SOMOS-HARDWARE-DESIGN/PRJ_CABINET_IOT/Manufacturing files/V1R1/PBM/PBM_CABINET-IOT_1.1.20261112.xlsx

Project: | CABINET IOT |  |  | Company: | Somos Internet
Revision: | V1R1 |  |  | Date: | 12/11/2026
Assembly Variant: | EVT-1 |  |  | Total Quantity: | 336
Description | Designator | Comment | Manufacturer | Manufacturer Part Number | Supplier | Supplier Part Number | Quantity
CAP CER 10uF 25V X5R 0603 | C1, C2, C105, C111, C116, C402, C403, C410, C413 | 10uF | Samsung Electro-Mechanics | CL10A106MA8NRNC | LCSC | C96446 | 9
CAP CER 100nF 50V X7R 0402 | C3, C4, C5, C6, C7, C8, C101, C103, C106, C109, C112, C115, C200, C203, C204, C206, C210, C211, C212, C213, C214, C215, C216, C217, C225, C226, C227, C229, C231, C233, C234, C235, C236, C237, C238, C239, C240, C243, C244, C301, C400, C401, C416, C417, C418, C419, C500, C501, C502, C503, C504, C506 | 0.1uF | YAGEO | AC0402KRX7R9BB104 | LCSC | C2888326 | 52
CAP SAFETY 220nF ±10% 275V 310V TH | C100, C119 | 220nF | WALSON | C42Q322448P40001 | LCSC | C46638866 | 2
CAP ALUM 100uF ±20% 50V SMD | C102 | 100uF | JIERR | RV50V100M8X10 | LCSC | C48935390 | 1
CAP CER 47uF 6.3V X5R 0805 | C107, C108 | 47uF | Samsung Electro-Mechanics | CL21A476MQYNNNE | LCSC | C16780 | 2
CAP CER 1uF 16V X5R 0402 | C110, C209, C218, C220, C221, C222, C228, C230, C232, C505 | 1uF | Samsung Electro-Mechanics | CL05A105KO5NNNC | LCSC | C29266 | 10
CAP CER 22uF 6.3V X5R 0603 | C113, C241, C242 | 22uF | Samsung Electro-Mechanics | CL10A226MQ8NRNC | LCSC | C59461 | 3
CAP SAFETY 2.2nF ±20% 250V TH | C117, C118 | 2.2nF | Dersonic | CY2222MD1IEF46J2A8 | LCSC | C2761720 | 2
CAP CER 10uF 10V X5R 0402 | C201, C202, C207, C219, C223, C224, C414, C415 | 10uF | Chinocera | HGC0402R5106M100NTEJ | LCSC | C7472949 | 8
CAP CER 470pF 25V NP0 0402 | C208 | 470pF | YAGEO | CC0402JRNPO8BN471 | LCSC | C541369 | 1
CAP CER 18pF 50V NP0 0402 | C245, C246 | 18pF | YAGEO | CC0402JRNPO9BN180 | LCSC | C106202 | 2
CAP CER 1nF 2kV X7R 1206 | C247, C507 | 1000pF | YAGEO | CC1206KKX7RDBB102 | LCSC | C23631 | 2
CAP CER 1nF 630V X7R 0603 | C248 | 1000pF | KEMET | C0603W102KBRAC7867 | LCSC | C3839369 | 1
CAP FILM 100nF ±5% 630V TH | C300 | 100nF | KYET | KP104J2J0702 | LCSC | C19273038 | 1
CAP SAFETY 470nF ±10% 275V TH | C404 | 470nF | WALSON | C42P247438P40001 | LCSC | C46638871 | 1
CAP ALUM 470uF ±20% 35V SMD | C405, C406 | 470uF | KNSCHA | RVT470UF35V67RV0056 | LCSC | C2836436 | 2
CAP CER 33nF 1kV X7R 1210 | C407, C408, C411 | 33nF | HUI JU | NV1210B333K102CEGN | LCSC | C720962 | 3
TVS Diode | D3, D4, D500, D501 | ESD | Slkor | SLESD0402-V05 | LCSC | C7496586 | 4
Default Diode | D100, D101 | 20V 1A | onsemi | MBR120VLSFT1G | LCSC | C48677824 | 2
LED EMERALD GREEN WATER CLEAR 0402 SMD | D200, D201 | GRN | EVERLIGHT | 16-213/GHC-YR1S1/3T | LCSC | C74338 | 2
DIODES S1M-13-F | D300, D301, D302 | S1M-13-F | DIODES | S1M-13-F | LCSC | C155378 | 3
Default Diode | D400, D402 | 1N4007FL | SMC | 1N4007FL | LCSC | C493190 | 2
Zener Diode | D401 | 1SMA4744A | MDD(Microdiode Semiconductor) | 1SMA4744A | LCSC | C173484 | 1
FERRITE BEAD 600Ω 0603 1LN | FB200, FB201 | 600OHM | TAI-TECH | HCB1608KF-601T20 | LCSC | C304319 | 2
CONN RCPT Type-C 16POS SMD | J1 | USB C | Korean Hroparts Elec | TYPE-C-31-M-12 | LCSC | C165948 | 1
Connector Accessories SFP Cage Right Angle Copper Alloy Nickel Tray | J200 | SFP 2227023 1X1Y | CND-tek | SFP 2227023 1X1Y | LCSC | C42931382 | 1
CONN SFP RCPT 20POS SLD R/A SMD | J201 | SFP20 47030-00J191 | CND-Tek | SFP20 47030-00J191 | LCSC | C50159076 | 1
CONN HEADER TH 3POS 2mm | J300, J301 | LS | JST | B3B-PH-K-S(LF)(SN) | LCSC | C131339 | 2
CONN MOD JACK RJ45 TH R/A SHIELDED | J500 | KH-RJ45-58-8P8C | kinghelm | KH-RJ45-58-8P8C | LCSC | C2683360 | 1
CONN HEADER TH 4POS 2mm | J501 | STH1 | JST | B4B-PH-K-S(LF)(SN) | LCSC | C131334 | 1
CONN HEADER TH 3POS 2mm | J503 | WS | JST | B3B-PH-K-S(LF)(SN) | LCSC | C131339 | 1
CONN HEADER TH 3POS 2mm | J504 | MQ-7 | JST | B3B-PH-K-S(LF)(SN) | LCSC | C131339 | 1
CONN HEADER TH 4POS 2mm | J505 | STH2 | JST | B4B-PH-K-S(LF)(SN) | LCSC | C131334 | 1
CONN HEADER TH 4POS 2mm | J507 | STH3 | JST | B4B-PH-K-S(LF)(SN) | LCSC | C131334 | 1
CONN HEADER TH 4POS 2mm | J508 | STH4 | JST | B4B-PH-K-S(LF)(SN) | LCSC | C131334 | 1
Songle Relay SRD-05VDC-SL-C | K300 | SRD-05VDC-SL-C | Songle Relay | SRD-05VDC-SL-C | LCSC | C35449 | 1
FIXED IND 12UH 1.4A 135 MOHM SMD | L100 | 15uH | cjiang | FNR5020S150MT | LCSC | C167939 | 1
Chip Inductor SMD | L201 | 2.2uH | TDK | VLS252010CX-2R2M-1 | LCSC | C2896594 | 1
CMC 1.5A 2LN 1.4KOHM SMD | LC100 | PDUUAT98-103MLN | PROD Tech | PDUUAT98-103MLN | LCSC | C2909797 | 1
RF TXRX MOD BT WIFI TH SMD | MOD1 | ESP32-WROOM-32E-N8 | Espressif Systems | ESP32-WROOM-32E-N8 | LCSC | C701342 | 1
Optocoupler DC-IN 1-CH Transistor DC-OUT 4-Pin PDIP SMD | OK400 | PC817CS | AOTE | PC817CS | LCSC | C20612591 | 1
TRANS NPN 40V 200mA SOT-23 | Q1, Q2 | NPN | onsemi | MMBT3904 | LCSC | C242260 | 2
MOSFET N-CH 60V 5.6A SOT-223 | Q300, Q301, Q302 | DMN6068SE-13 | DIODES | DMN6068SE-13 | LCSC | C209902 | 3
P-Channel Power MOSFET | Q500 | AO3401 | UMW | AO3401 | LCSC | C347476 | 1
N-Channel Power MOSFET | Q501 | AO3400 | UMW | AO3400 | LCSC | C347475 | 1
RES 5.1kΩ ±1% 62.5mW 0402 | R1, R2, R6, R7, R26, R27, R200, R201, R202, R203, R204, R235, R236, R240, R241, R242, R248, R421, R424, R425, R426 | 5.1K | YAGEO | RC0402FR-075K1L | LCSC | C105872 | 21
RES 1kΩ ±1% 62.5mW 0402 | R3, R5, R12, R13, R14, R30, R31, R32, R40, R41, R42, R43, R44, R45, R46, R47, R205, R400, R406, R407, R408, R409 | 1K | YAGEO | RC0402FR-071KL | LCSC | C106235 | 22
RES 0Ω ±5% 100mW 0603 | R4, R232, R239, R404, R504, R505, R508 | 0R | YAGEO | RC0603JR-070RL | LCSC | C95177 | 7
Chip Resistor SMD | R10, R11 | 470R | YAGEO | RC0402FR-07470RL | LCSC | C114877 | 2
RES 100Ω ±1% 62.5mW 0402 | R15, R16, R17, R18, R19, R245, R301, R303, R306 | 100R | YAGEO | RC0402FR-07100RL | LCSC | C106232 | 9
RES 22Ω ±1% 62.5mW 0402 | R20, R21, R500, R501 | 22R | YAGEO | RC0402FR-0722RL | LCSC | C114765 | 4
RES 0Ω ±1% 62.5mW 0402 | R22, R29, R48, R49, R50, R51, R52, R53, R54, R55, R56, R57, R58, R59, R60, R61, R62, R63, R206, R208, R237, R238, R502 | 0R | YAGEO | RC0402FR-070RL | LCSC | C106231 | 23
RES 10kΩ ±1% 62.5mW 0402 | R23, R24, R25, R28, R33, R35, R37, R39, R100, R215, R225, R226, R227, R231, R251, R302, R304, R305, R307, R308, R423, R427, R428, R431, R432, R503, R507, R509 | 10K | YAGEO | RC0402FR-0710KL | LCSC | C60490 | 28
RES 100kΩ ±1% 100mW 0603 | R101 | 100k | FOJAN | FRC0603F1003TS | LCSC | C2906980 | 1
RES 13.3kΩ ±1% 100mW 0603 | R102 | 13.3k | FOJAN | FRC0603F1332TS | LCSC | C2933140 | 1
RES 1.5kΩ ±1% 62.5mW 0402 | R207 | 1.5k | YAGEO | RC0402FR-071K5L | LCSC | C114759 | 1
RES 10Ω ±1% 62.5mW 0402 | R209, R210, R216, R252 | 10R | UNI-ROYAL | 0402WGF100JTCE | LCSC | C25077 | 4
RES 49.9Ω ±1% 62.5mW 0402 | R211, R212, R213, R214 | 49.9R | FOJAN | FRC0402F49R9TS | LCSC | C2933103 | 4
RES 27Ω ±1% 62.5mW 0402 | R217, R218 | 27R | FOJAN | FRC0402F27R0TS | LCSC | C2909343 | 2
RES 33Ω ±1% 62.5mW 0402 | R219, R223 | 33R | YAGEO | RC0402FR-0733RL | LCSC | C138002 | 2
RES 12.1kΩ ±1% 62.5mW 0402 | R222 | 12.1k | UNI-ROYAL | 0402WGF1212TCE | LCSC | C25852 | 1
RES 75Ω ±1% 100mW 0603 | R243, R244 | 75R | HWA CHN | HRC0603F75R0ENTN | LCSC | C54920947 | 2
RES 2.49kΩ ±1% 62.5mW 0402 | R249 | 2.49K | FOJAN | FRC0402F2491TS | LCSC | C2933083 | 1
RES 100Ω ±5% 1W 2512 | R300, R402, R403 | 100R | FOJAN | FRC2512J101 TS | LCSC | C2907569 | 3
RES 470kΩ ±1% 500mW 1210 | R401 | 470k | FOJAN | FRC1210F4703TS | LCSC | C3000657 | 1
RES 10kΩ ±1% 500mW 1210 | R405, R414 | 10k | FOJAN | FRC1210F1002TS | LCSC | C2974059 | 2
RES 1kΩ ±1% 500mW 1210 | R410, R415, R420 | 1k | FOJAN | FRC1210F1001TS | LCSC | C2960861 | 3
RES 249Ω ±1% 500mW 1210 | R412, R413 | 249R | FOJAN | FRC1210F2490TS | LCSC | C3000542 | 2
RES 330kΩ ±1% 500mW 1210 | R417, R418, R419 | 330k | FOJAN | FRC1210F3303TS | LCSC | C51048344 | 3
PTC RESET FUSE 250V 600mA TH | RT100 | BK250-600-SZ | Brightking | BK250-600-SZ | LCSC | C94464 | 1
SPST- NO Momentary Button, 160g Force | S1, S2 | EVQ-P2202M | Panasonic | EVQ-P2202M | LCSC | C528967 | 2
CHIP LAN FILTER, Meets IEEE 802.3 & ANSI X3.263 Standards, Designed For 2.5G BASE - T Applications, Surface Mount Type | T200, T201 | CM3216D25-501 | CND-tek | CM3216D25-501 | LCSC | C41425874 | 2
Ultra Low ON-Resistance, Low Voltage, Dual, SPDT Analog Switch | U1 | SGM3005XMS/TR | SGMICRO | SGM3005XMS/TR | LCSC | C19618 | 1
Transceiver USB 2.0 2Mbps SOP-16_150mil USB ICs RoHS | U2 | CH340C | WCH | CH340C | LCSC | C84681 | 1
Multiplexer Switch ICs 8-CH I2C SWITCH W/RESET | U3 | PCA9548APW,118 | NXP | PCA9548APW,118 | LCSC | C21198 | 1
20W Series of Ultra-compact Power Module | U100 | HLK-20M12 | HI-LINK | HLK-20M12 | LCSC | C465408 | 1
High Efficiency Fast Response, 5A, 30V Input Synchronous Step Down Regulator | U101 | SY8205FCC | Silergy | SY8205FCC | LCSC | C111875 | 1
3.3V Positive Fixed SOT-223 Voltage Regulators - Linear, Low Drop Out (LDO) Regulators | U102 | BL8071GCLBTR33 | BL | BL8071GCLBTR33 | LCSC | C49256292 | 1
Small Footprint RMII 10/100 Ethernet Transceiver with HP Auto-MDiX Support | U200 | LAN8720A-CP-TR | Microchip | LAN8720A-CP-TR | LCSC | C45223 | 1
10/100/1000M Copper to 100Base-FX/1000Base-X Fiber Media Converter | U201 | RTL8213B-CG | Realtek | RTL8213B-CG | LCSC | C2766076 | 1
SINGLE 2-INPUT POSITIVE OR GATE | U300 | 74LVC1G32SE-7 | DIODES | 74LVC1G32SE-7 | LCSC | C460530 | 1
16-Bit ADC with Integrated Multiplexer, PGA, Comparator, Oscillator, and Reference, -40 to 125 degC, 10-pin SOP (DGS10), Green (RoHS & no Sb/Br) | U400 | ADS1115IDGSR | Texas Instruments | ADS1115IDGSR | LCSC | C37593 | 1
Low-dropout linear regulator with 250 mA output current, 55 V voltage withstand, and low quiescent current | U401 | HT7550H-TD(55V) | TDSEMIC | HT7550H-TD(55V) | LCSC | C49023494 | 1
Low-Power, RRIO, 1-MHz Operational Amplifier for Cost-Sensitive Systems | U402, U404 | TLV9002IDR | TI | TLV9002IDR | LCSC | C398360 | 2
Single-phase metering IC | U403 | HLW8032 | Hiliwei Tech | HLW8032 | LCSC | C128023 | 1
3V to 5.5V multi-channel RS-232 line drivers and receivers with +15kV IEC ESD protection | U500 | MAX3232EIPWR | TI | MAX3232EIPWR | LCSC | C406863 | 1
Three-axis micromachined digital accelerometer | U501 | SC7A20HTR | Hangzhou Silan Microelectronics | SC7A20HTR | LCSC | C19274408 | 1
810V 385V 300V 470V Through Hole,P=5mm Varistors, MOVs | VR100, VR400 | FTR05D471K-C3Z3 | SURGING | FTR05D471K-C3Z3 | LCSC | C55233803 | 2
TERM BLOCK HDR 2POS 7.5MM | X100 | AC INPUT | Cixi Kefa Elec | KF2EDGRC-7.5-2P | LCSC | C976440 | 1
CRYSTAL 25MHz 16pF SMD | X200 | 25Mhz | YXC Crystal Oscillators | X322525MQB4SI | LCSC | C70585 | 1
TERM BLOCK HDR 2POS 7.5MM | X300 | FAN 1/2 | Cixi Kefa Elec | KF2EDGRC-7.5-2P | LCSC | C976440 | 1
TERM BLOCK HDR 2POS 7.5MM | X301 | FAN 3/4 | Cixi Kefa Elec | KF2EDGRC-7.5-2P | LCSC | C976440 | 1
TERM BLOCK HDR 2POS 5MM | X302, X303 | ElectroMagnet | Cixi Kefa Elec | KF2EDGRC-5.0-2P | LCSC | C441225 | 2
TERM BLOCK HDR 2POS 5MM | X401, X402, X403 | CT CLAMP DC | Cixi Kefa Elec | KF2EDGRC-5.0-2P | LCSC | C441225 | 3
XTAL OSC 50MHz CMOS SMD | Y200 | 50MHz | SCTF | SX2M50.000M20F30TNN | LCSC | C2901606 | 1
