SOMOS-HARDWARE-DESIGN/PRJ_CABINET_IOT/Manufacturing files/V1R1/2D-3D/P3D_CABINET-IOT_1.1.20261112.step/P3D_CABINET-IOT_1.1.20261112.step

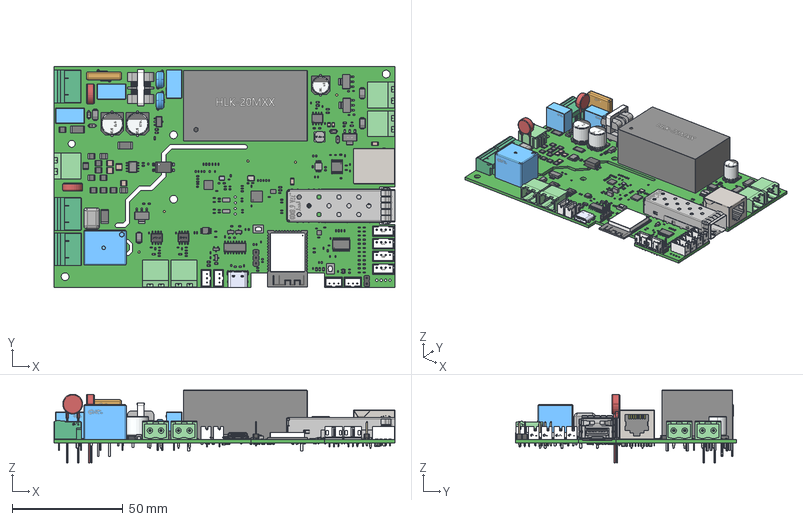
[picture p1: CAD file, 2026-11-13]
Manufacturing files/V1R1/2D-3D/P3D_CABINET-IOT_1.1.20261112.step/P3D_CABINET-IOT_1.1.20261112.step
154.0 x 100.0 x 32.8 mm
pin_header_aw140-eg-g02d
User Library-3-lead sot23-3 x 4
Mid_Body x 159
Mark x 159
Extruded x 30
CAP-TH_L13.0-W7.0-P10.00-D0.6-1 x 3
CAP-TH_L7.5-W3.7-P7.50-D0.6-S2.0 x 2
FILTER-TH_4P-L17.0-W12.0-H16.5-P7.00-D0.6-S8.00
D0402_L1.0-W0.5-H0.5 x 4
Pin1 x 13
Pin2 x 13
CeramicBody x 13
CONN-TH_P5.00_KF2EDGRC-5.0-2P x 5
Pin001 x 2
Pin002 x 2
Pin003 x 2
Pin004 x 2
Pin005 x 2
Pin006 x 2
Pin007 x 2
Pin008 x 2
74AHCT1G32SE-7
User Library-SOT-223-1 x 3
CONN-TH_B3B-PH-K-S x 4
User Library-DO-214AC SMA x 4
OSC-SMD_4P-L2.5-W2.0-H0.6
CONN-TH_KF2EDGRC-7.5-2P x 3
User Library-3225-1
mov-07d221k_RGB153 x 2
LGA-12_L2.0-W2.0-P0.50-TL_QMA6100
Leader x 74
SOP-8_L4.9-W3.9-P1.27-LS6.0-BL-1
top
bottom
Thermal Shape
SOT-223-3_L6.5-W3.4-P2.30-LS7.0-BR
PWRM-TH_HLK-20MXX
FUSE-TH_L16.0-W4.6-H18.0-P5.1-D0.8-S4.6
pin_header_aw140-eg-g03d
User Library-DIP4_opto_iso
ESP32-WROOM-32D--3DModel-STEP-56544
VLS252010CX-2R2M-1
SRN5020TA
RELAY-TH_L19.2-W15.6-H15.8
PH2.0-LI-4P x 4
RJ45-TH_KH-RJ45-58-8P8C
User Library-SOD123F x 4
User Library-led_0402LED0402 green x 2
CAP ALUM 10_3mm x 2
leads
CAP ALUM 8_3mm
