SOMOS-HARDWARE-DESIGN/PRJ_CABINET_IOT/Manufacturing files/V1R1/PCB MFG-ASY-SCH PDF/PCB_MFG_PDF_CABINET-IOT_1.1.20261112.pdf

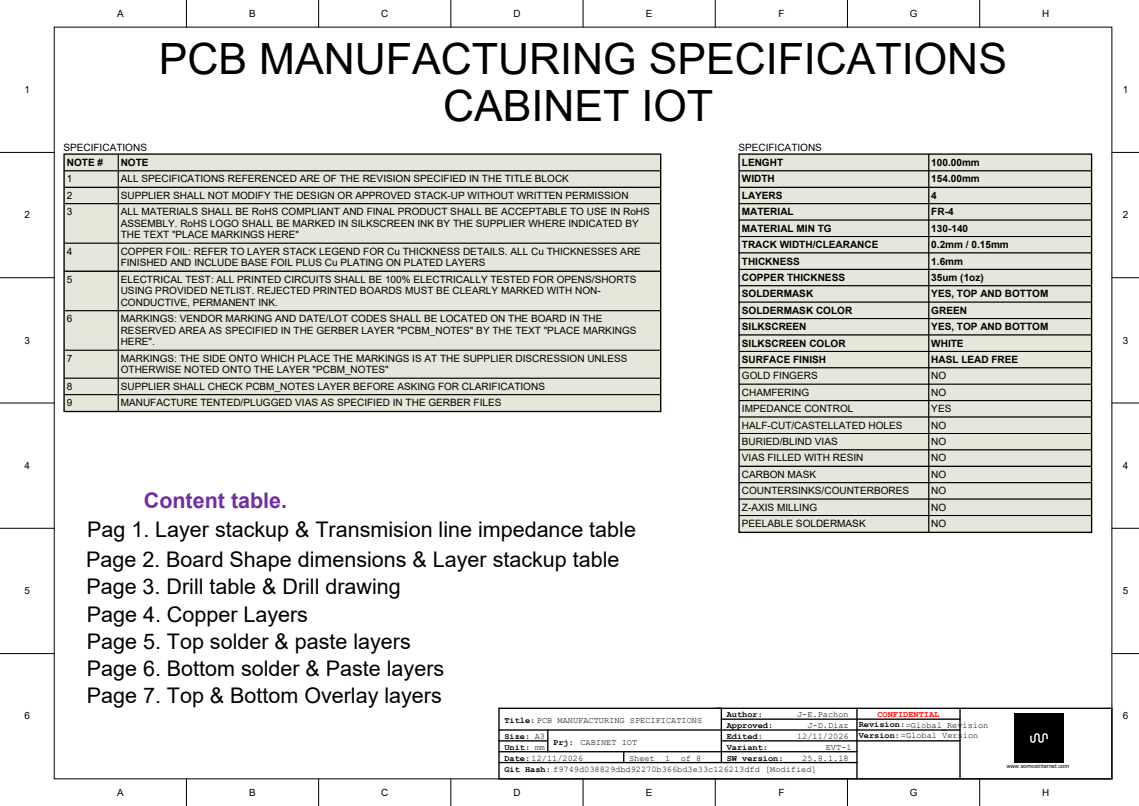
[picture p2: page 1]

NOTE
ALL SPECIFICATIONS REFERENCED ARE OF THE REVISION SPECIFIED IN THE TITLE BLOCK
SUPPLIER SHALL NOT MODIFY THE DESIGN OR APPROVED STACK-UP WITHOUT WRITTEN PERMISSION
ALL MATERIALS SHALL BE RoHS COMPLIANT AND FINAL PRODUCT SHALL BE ACCEPTABLE TO USE IN RoHS
ASSEMBLY. RoHS LOGO SHALL BE MARKED IN SILKSCREEN INK BY THE SUPPLIER WHERE INDICATED BY
THE TEXT "PLACE MARKINGS HERE"

MATERIAL MIN TG | 130-140
TRACK WIDTH/CLEARANCE | 0.2mm / 0.15mm
THICKNESS | 1.6mm

4 | COPPER FOIL: REFER TO LAYER STACK LEGEND FOR Cu THICKNESS DETAILS. ALL Cu THICKNESSES ARE FINISHED AND INCLUDE BASE FOIL PLUS Cu PLATING ON PLATED LAYERS

ELECTRICAL TEST: ALL PRINTED CIRCUITS SHALL BE 100% ELECTRICALLY TESTED FOR OPENS/SHORTS
USING PROVIDED NETLIST. REJECTED PRINTED BOARDS MUST BE CLEARLY MARKED WITH NON-
CONDUCTIVE, PERMANENT INK.

SOLDERMASK | YES, TOP AND BOTTOM
SOLDERMASK COLOR | GREEN
SILKSCREEN | YES, TOP AND BOTTOM
SILKSCREEN COLOR | WHITE

6 | MARKINGS: VENDOR MARKING AND DATE/LOT CODES SHALL BE LOCATED ON THE BOARD IN THE RESERVED AREA AS SPECIFIED IN THE GERBER LAYER "PCBM_NOTES" BY THE TEXT "PLACE MARKINGS HERE".

MARKINGS: THE SIDE ONTO WHICH PLACE THE MARKINGS IS AT THE SUPPLIER DISCRESSION UNLESS
OTHERWISE NOTED ONTO THE LAYER "PCBM_NOTES"

GOLD FINGERS | NO
CHAMFERING | NO
IMPEDANCE CONTROL | YES
HALF-CUT/CASTELLATED HOLES | NO
BURIED/BLIND VIAS | NO
VIAS FILLED WITH RESIN | NO
CARBON MASK | NO
COUNTERSINKS/COUNTERBORES | NO
Z-AXIS MILLING | NO
PEELABLE SOLDERMASK | NO

8 | SUPPLIER SHALL CHECK PCBM_NOTES LAYER BEFORE ASKING FOR CLARIFICATIONS
9 | MANUFACTURE TENTED/PLUGGED VIAS AS SPECIFIED IN THE GERBER FILES

Content table.
Pag 1. Layer stackup & Transmision line impedance table
Page 2. Board Shape dimensions & Layer stackup table
Page 3. Drill table & Drill drawing
Page 4. Copper Layers
Page 5. Top solder & paste layers
Page 6. Bottom solder & Paste layers
Page 7. Top & Bottom Overlay layers

Title: PCB MANUFACTURING SPECIFICATIONS | Author: J-E.Pachon | CONFIDENTIAL | www.somosinternet.com

Approved: J-D.Diaz | Revision: =Global_Revision

Size: A3 | Prj: CABINET IOT | Edited: 12/11/2026 | Version: =Global_Version
Unit: mm | | Variant: EVT-1
Date:12/11/2026 | Sheet 1 of 8 | SW version: 25.8.1.18

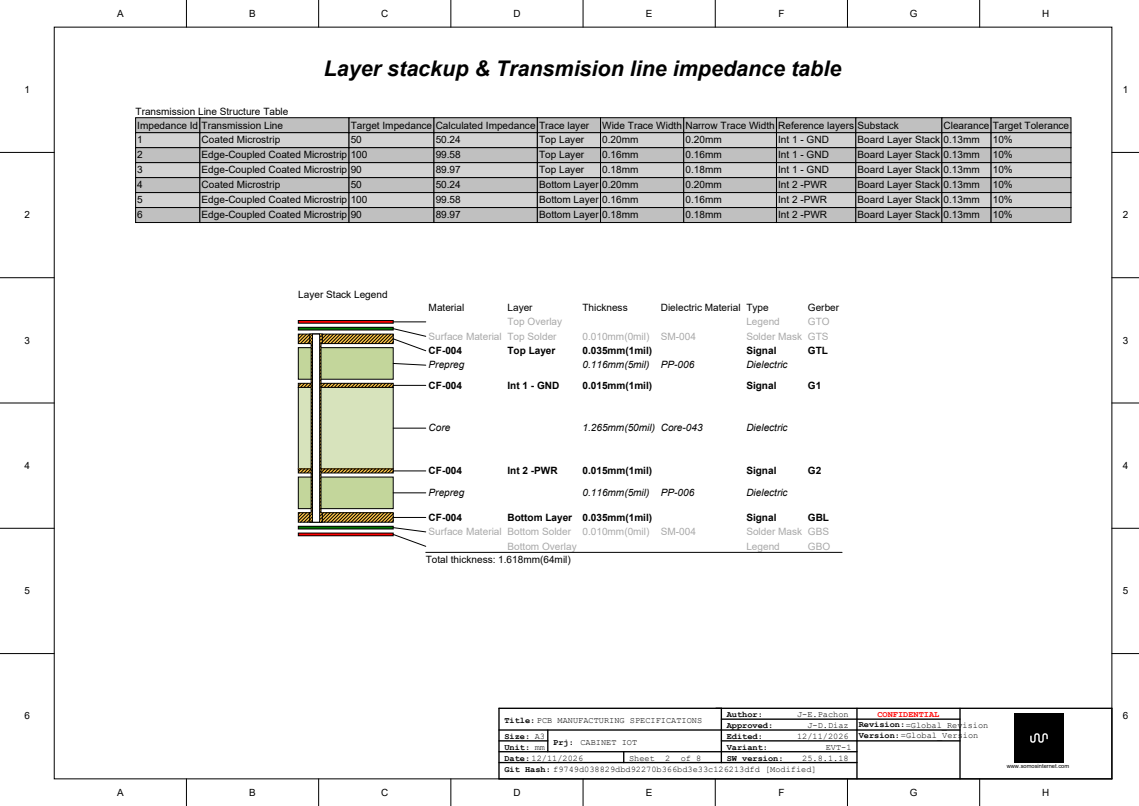
[picture p3: page 2]

Layer stackup & Transmision line impedance table

Transmission Line Structure Table

Impedance Id | Transmission Line | Target Impedance | Calculated Impedance | Trace layer | Wide Trace Width | Narrow Trace Width | Reference layers | Substack | Clearance | Target Tolerance
1 | Coated Microstrip | 50 | 50.24 | Top Layer | 0.20mm | 0.20mm | Int 1 - GND | Board Layer Stack | 0.13mm | 10%
2 | Edge-Coupled Coated Microstrip | 100 | 99.58 | Top Layer | 0.16mm | 0.16mm | Int 1 - GND | Board Layer Stack | 0.13mm | 10%
3 | Edge-Coupled Coated Microstrip | 90 | 89.97 | Top Layer | 0.18mm | 0.18mm | Int 1 - GND | Board Layer Stack | 0.13mm | 10%
4 | Coated Microstrip | 50 | 50.24 | Bottom Layer | 0.20mm | 0.20mm | Int 2 -PWR | Board Layer Stack | 0.13mm | 10%
5 | Edge-Coupled Coated Microstrip | 100 | 99.58 | Bottom Layer | 0.16mm | 0.16mm | Int 2 -PWR | Board Layer Stack | 0.13mm | 10%
6 | Edge-Coupled Coated Microstrip | 90 | 89.97 | Bottom Layer | 0.18mm | 0.18mm | Int 2 -PWR | Board Layer Stack | 0.13mm | 10%

Title: PCB MANUFACTURING SPECIFICATIONS | Author: J-E.Pachon | CONFIDENTIAL

Approved: J-D.Diaz | Revision: =Global_Revision

Size: A3 | | Edited: 12/11/2026 | Version: =Global_Version

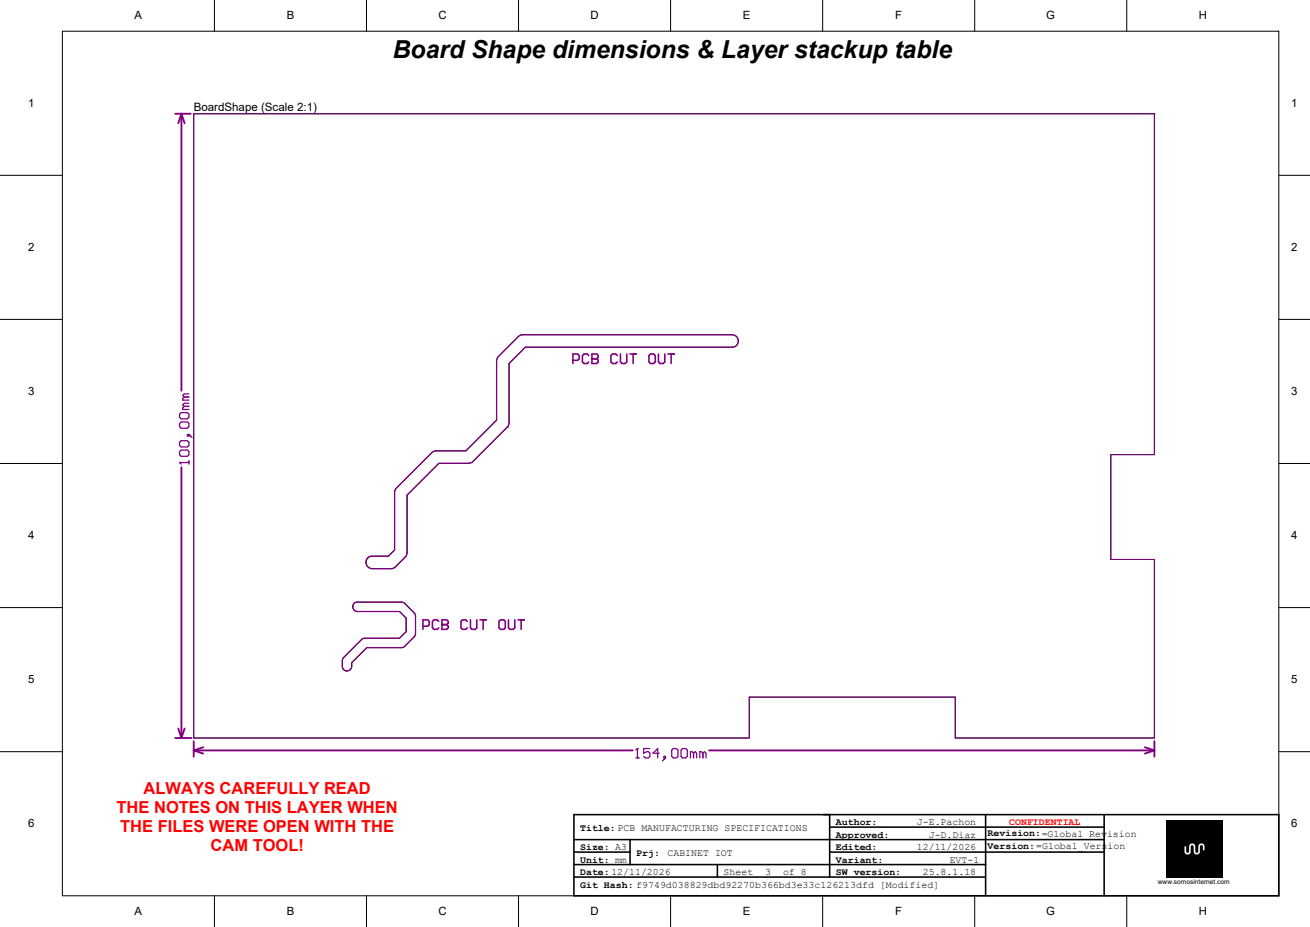
[picture p4: page 3]

Board Shape dimensions & Layer stackup table

ALWAYS CAREFULLY READ
THE NOTES ON THIS LAYER WHEN
THE FILES WERE OPEN WITH THE

Title: PCB MANUFACTURING SPECIFICATIONS | Author: J-E.Pachon | CONFIDENTIAL

Approved: J-D.Diaz | Revision: =Global_Revision

Size: A3 | | Edited: 12/11/2026 | Version: =Global_Version

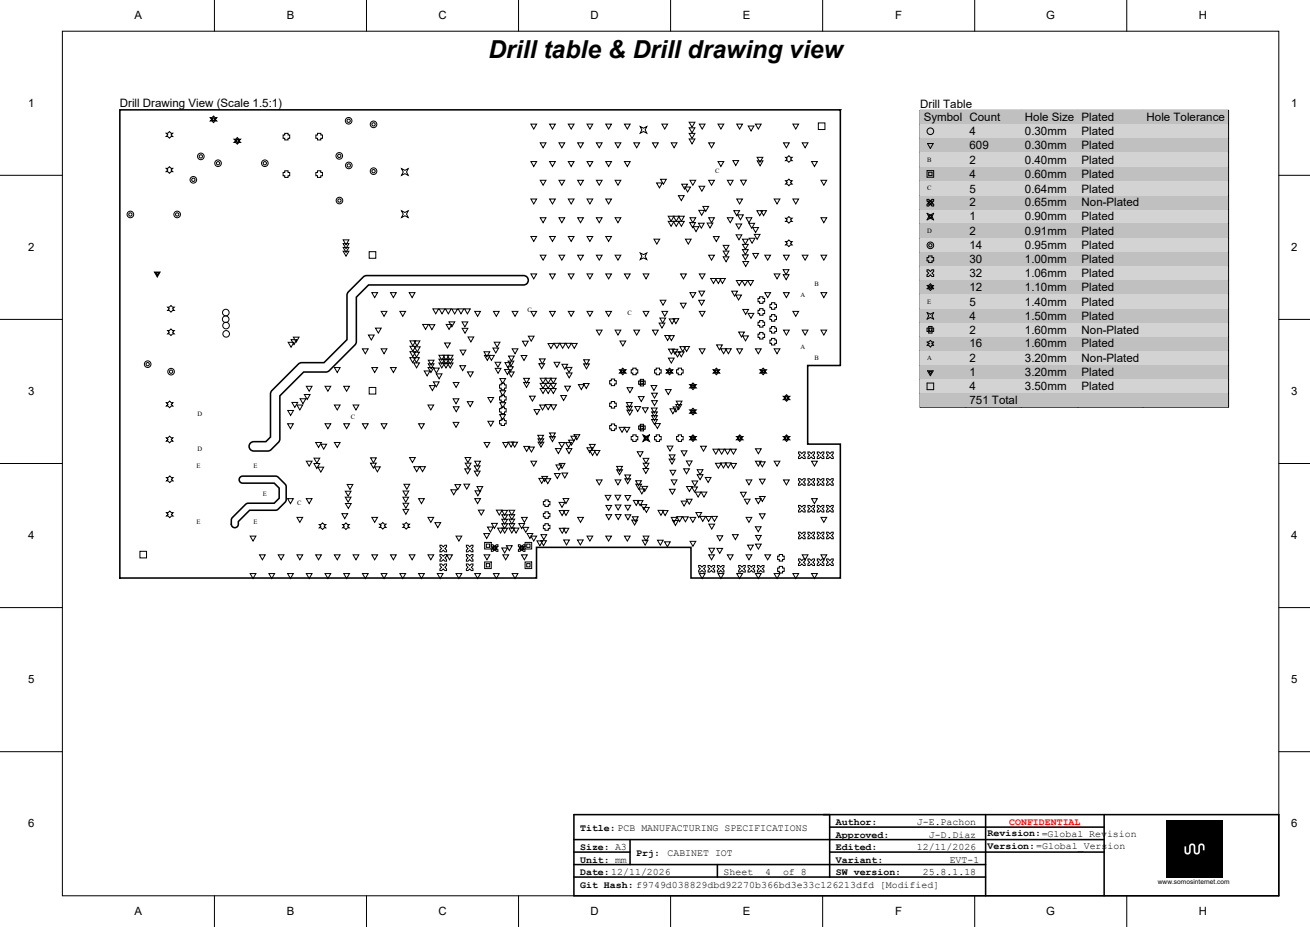
[picture p5: page 4]

Drill table & Drill drawing view

Drill Drawing View (Scale 1.5:1)

Symbol | Count | Hole Size | Plated | Hole Tolerance

4 | 0.30mm | Plated
609 | 0.30mm | Plated

B | 2 | 0.40mm | Plated

4 | 0.60mm | Plated

C | | | 5 | 0.64mm | Plated

2 | 0.65mm | Non-Plated
1 | 0.90mm | Plated

D | | | 2 | 0.91mm | Plated

14 | 0.95mm | Plated
30 | 1.00mm | Plated
32 | 1.06mm | Plated
12 | 1.10mm | Plated

E | | | 5 | 1.40mm | Plated

4 | 1.50mm | Plated
2 | 1.60mm | Non-Plated
16 | 1.60mm | Plated

A | | | 2 | 3.20mm | Non-Plated

1 | 3.20mm | Plated
4 | 3.50mm | Plated
751 Total

Title: PCB MANUFACTURING SPECIFICATIONS | Author: J-E.Pachon | CONFIDENTIAL

Approved: J-D.Diaz | Revision: =Global_Revision

Size: A3 | | Edited: 12/11/2026 | Version: =Global_Version

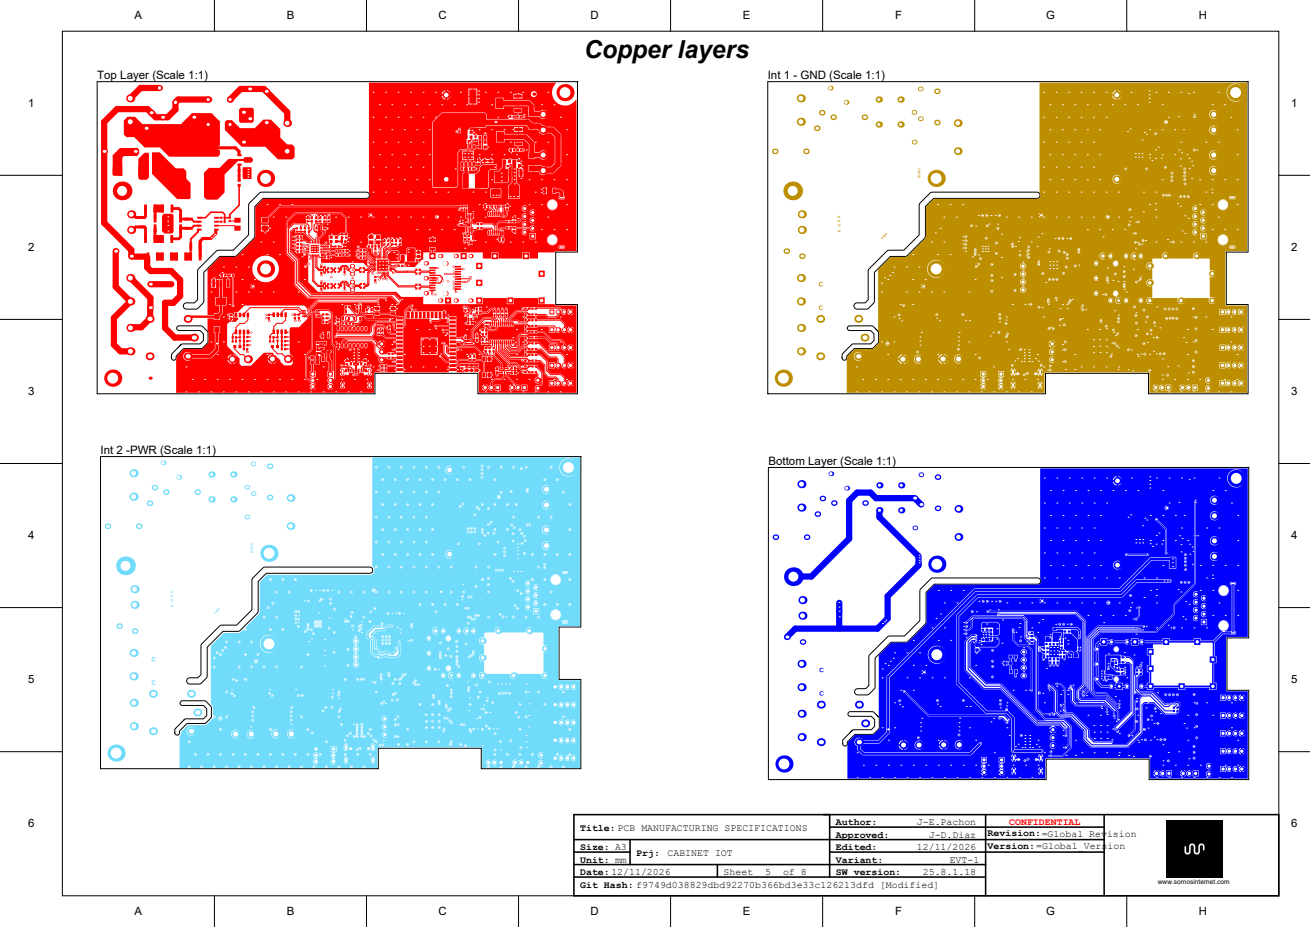
[picture p6: page 5]

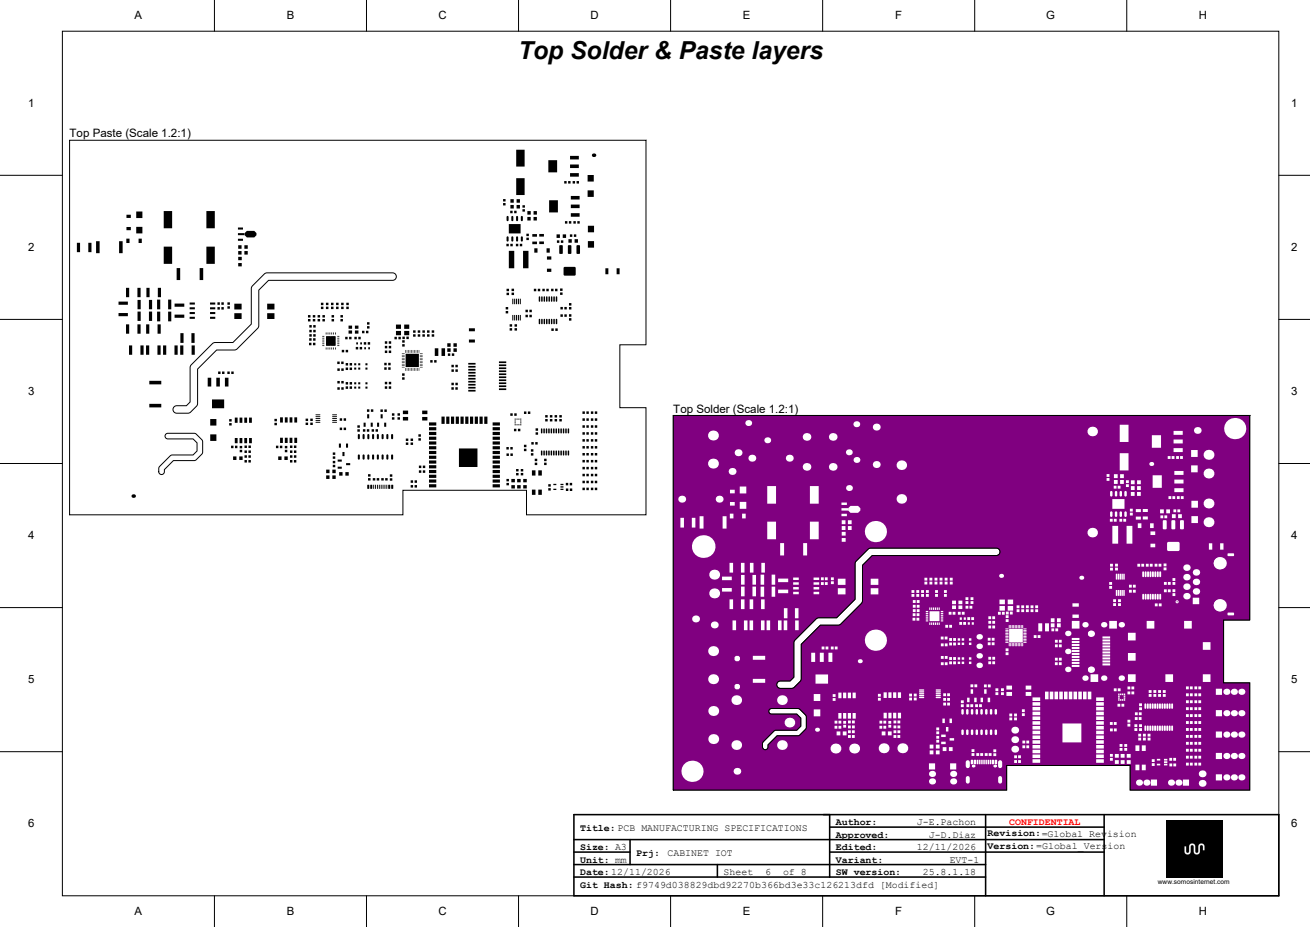
[picture p7: page 6]

Top Solder & Paste layers

Title: PCB MANUFACTURING SPECIFICATIONS | Author: J-E.Pachon | CONFIDENTIAL

Approved: J-D.Diaz | Revision: =Global_Revision

Size: A3 | | Edited: 12/11/2026 | Version: =Global_Version

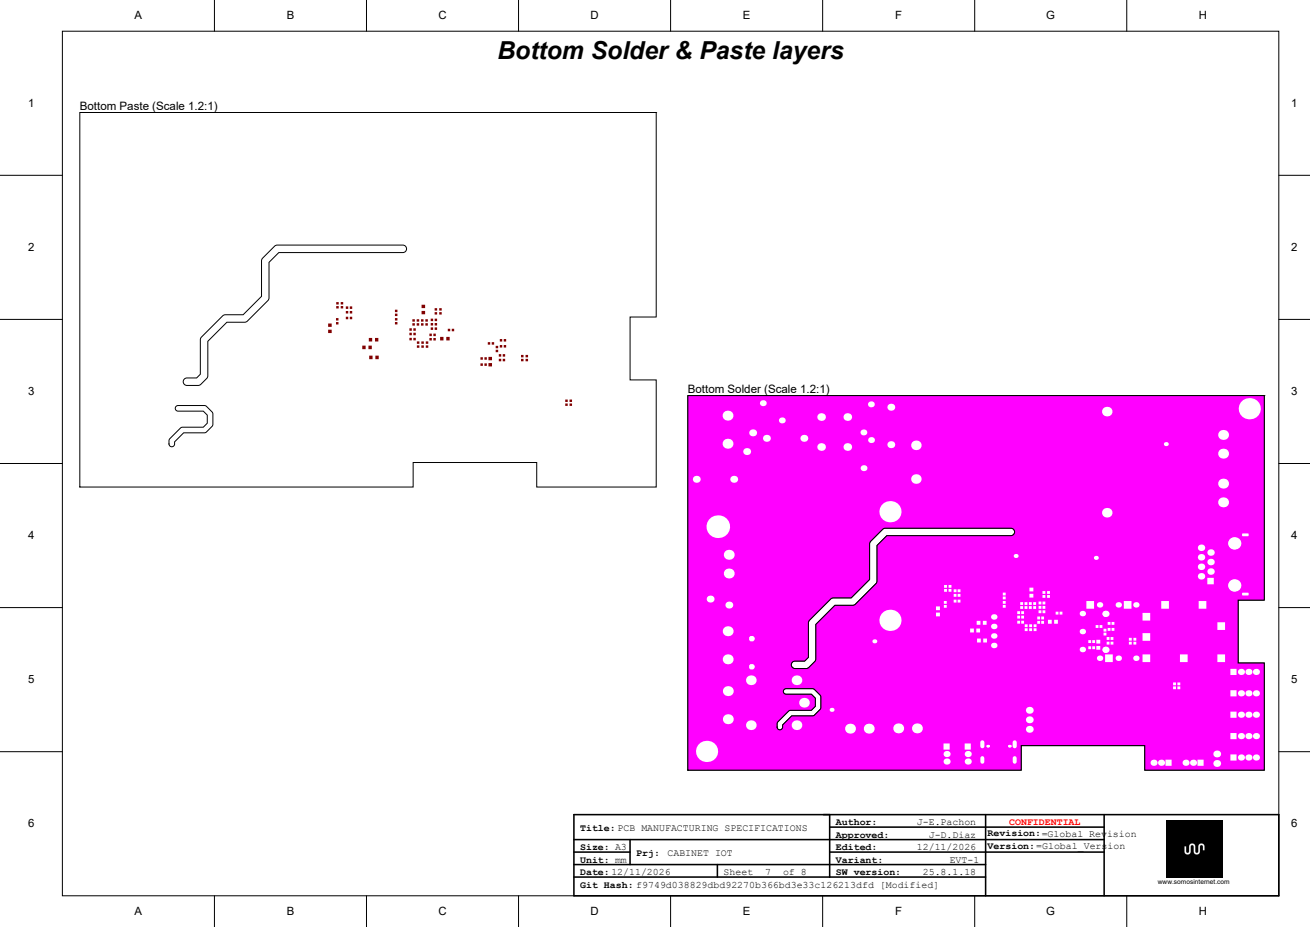
[picture p8: page 7]

Bottom Solder & Paste layers

Title: PCB MANUFACTURING SPECIFICATIONS | Author: J-E.Pachon | CONFIDENTIAL

Approved: J-D.Diaz | Revision: =Global_Revision

Size: A3 | | Edited: 12/11/2026 | Version: =Global_Version

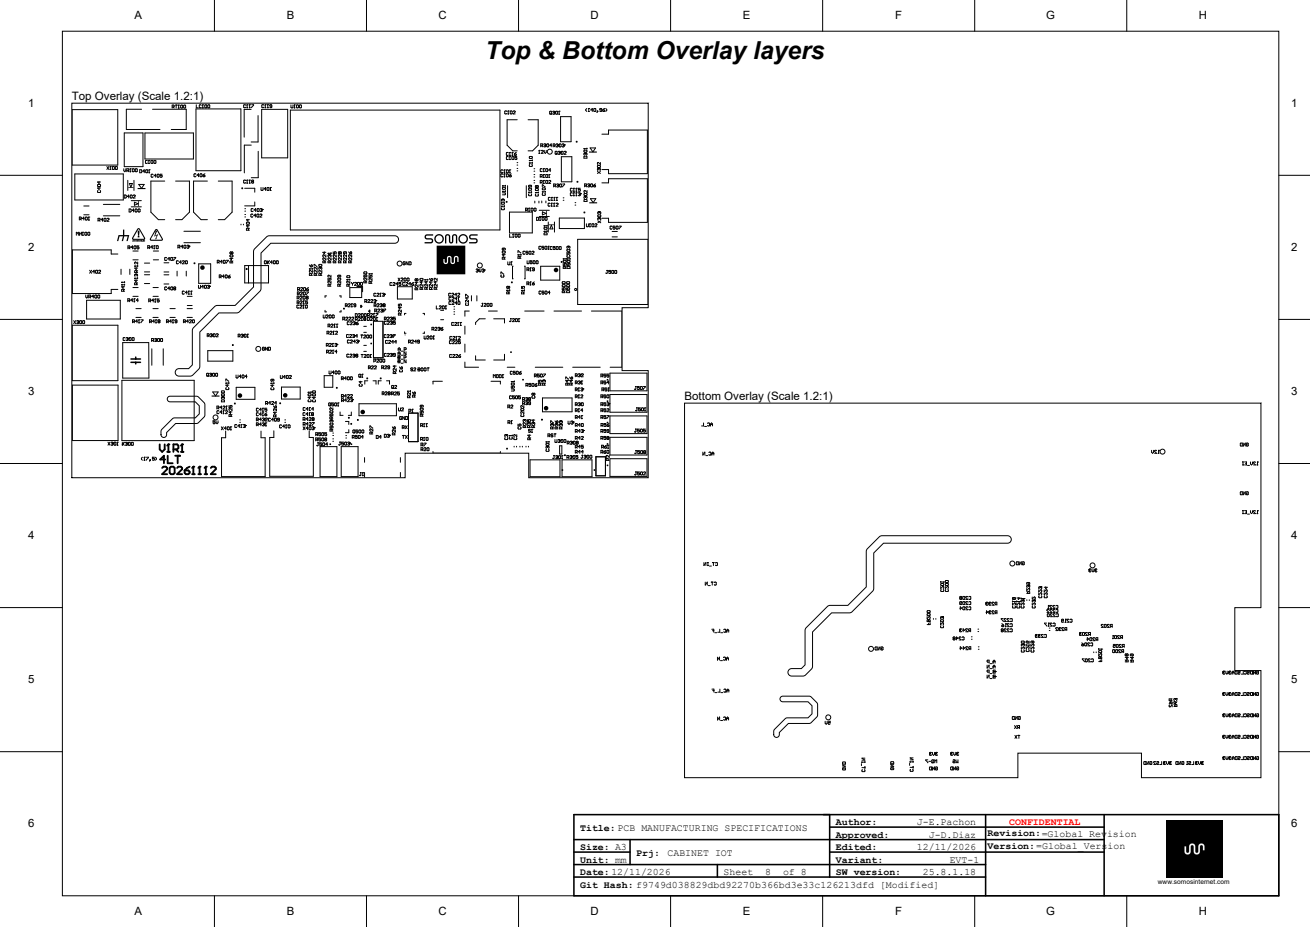
[picture p9: page 8]

Top & Bottom Overlay layers
