SOMOS-HARDWARE-DESIGN/PRJ_CABINET_IOT/Manufacturing files/V1R1/PCB MFG-ASY-SCH PDF/SCH_PDF_CABINET-IOT_1.1.20261112.pdf

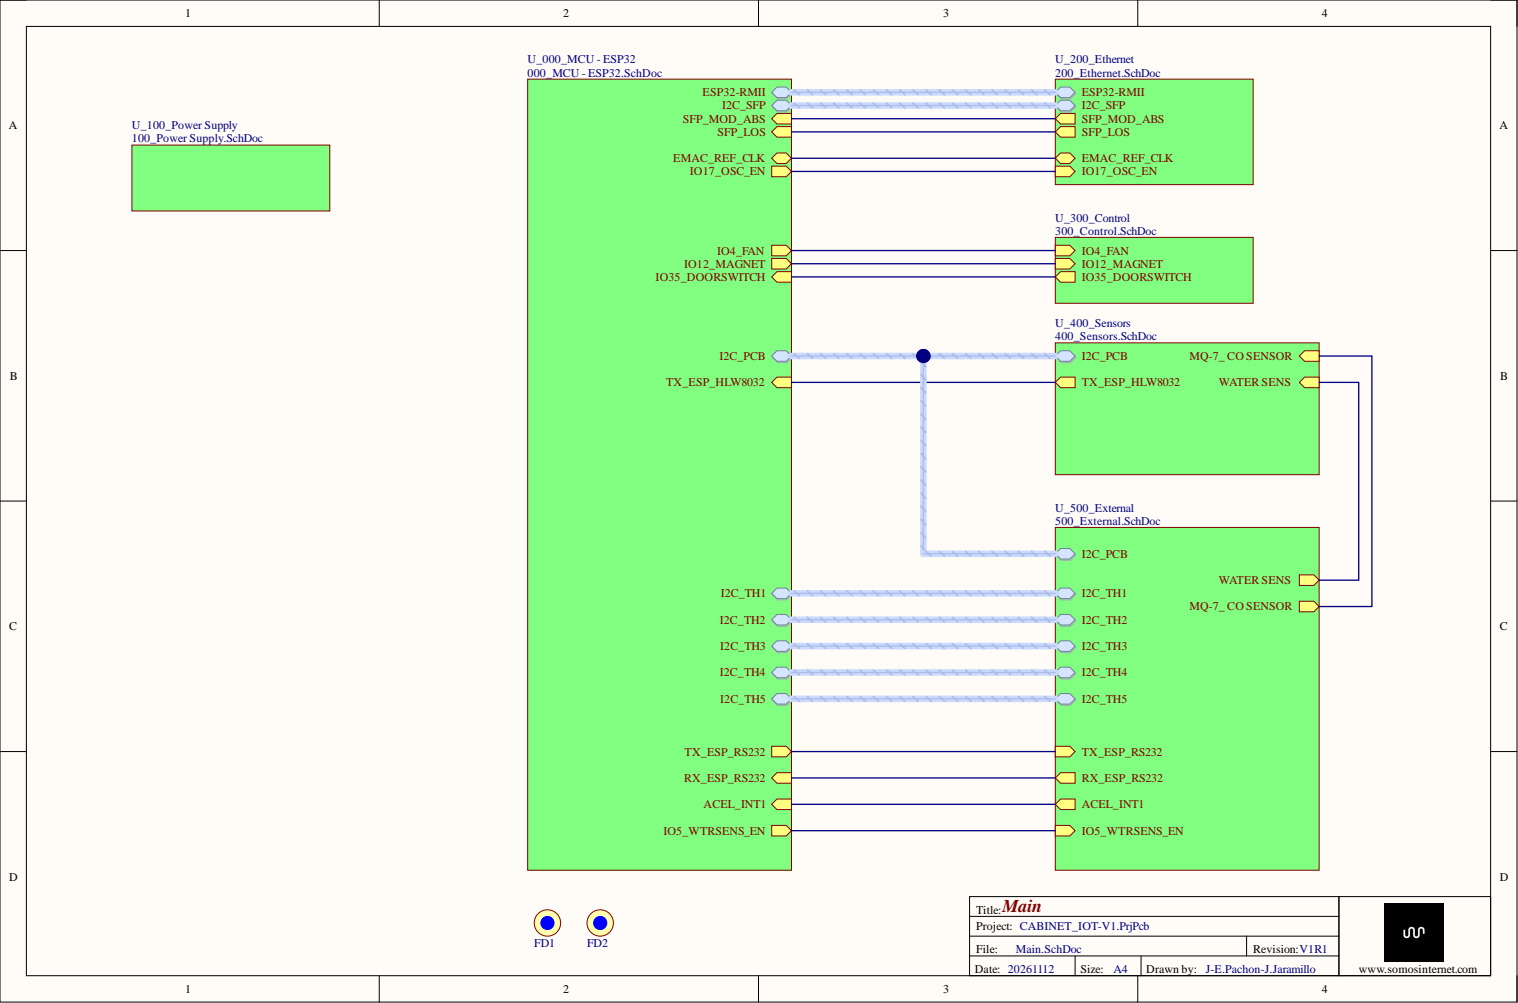
[picture p10: page 1]

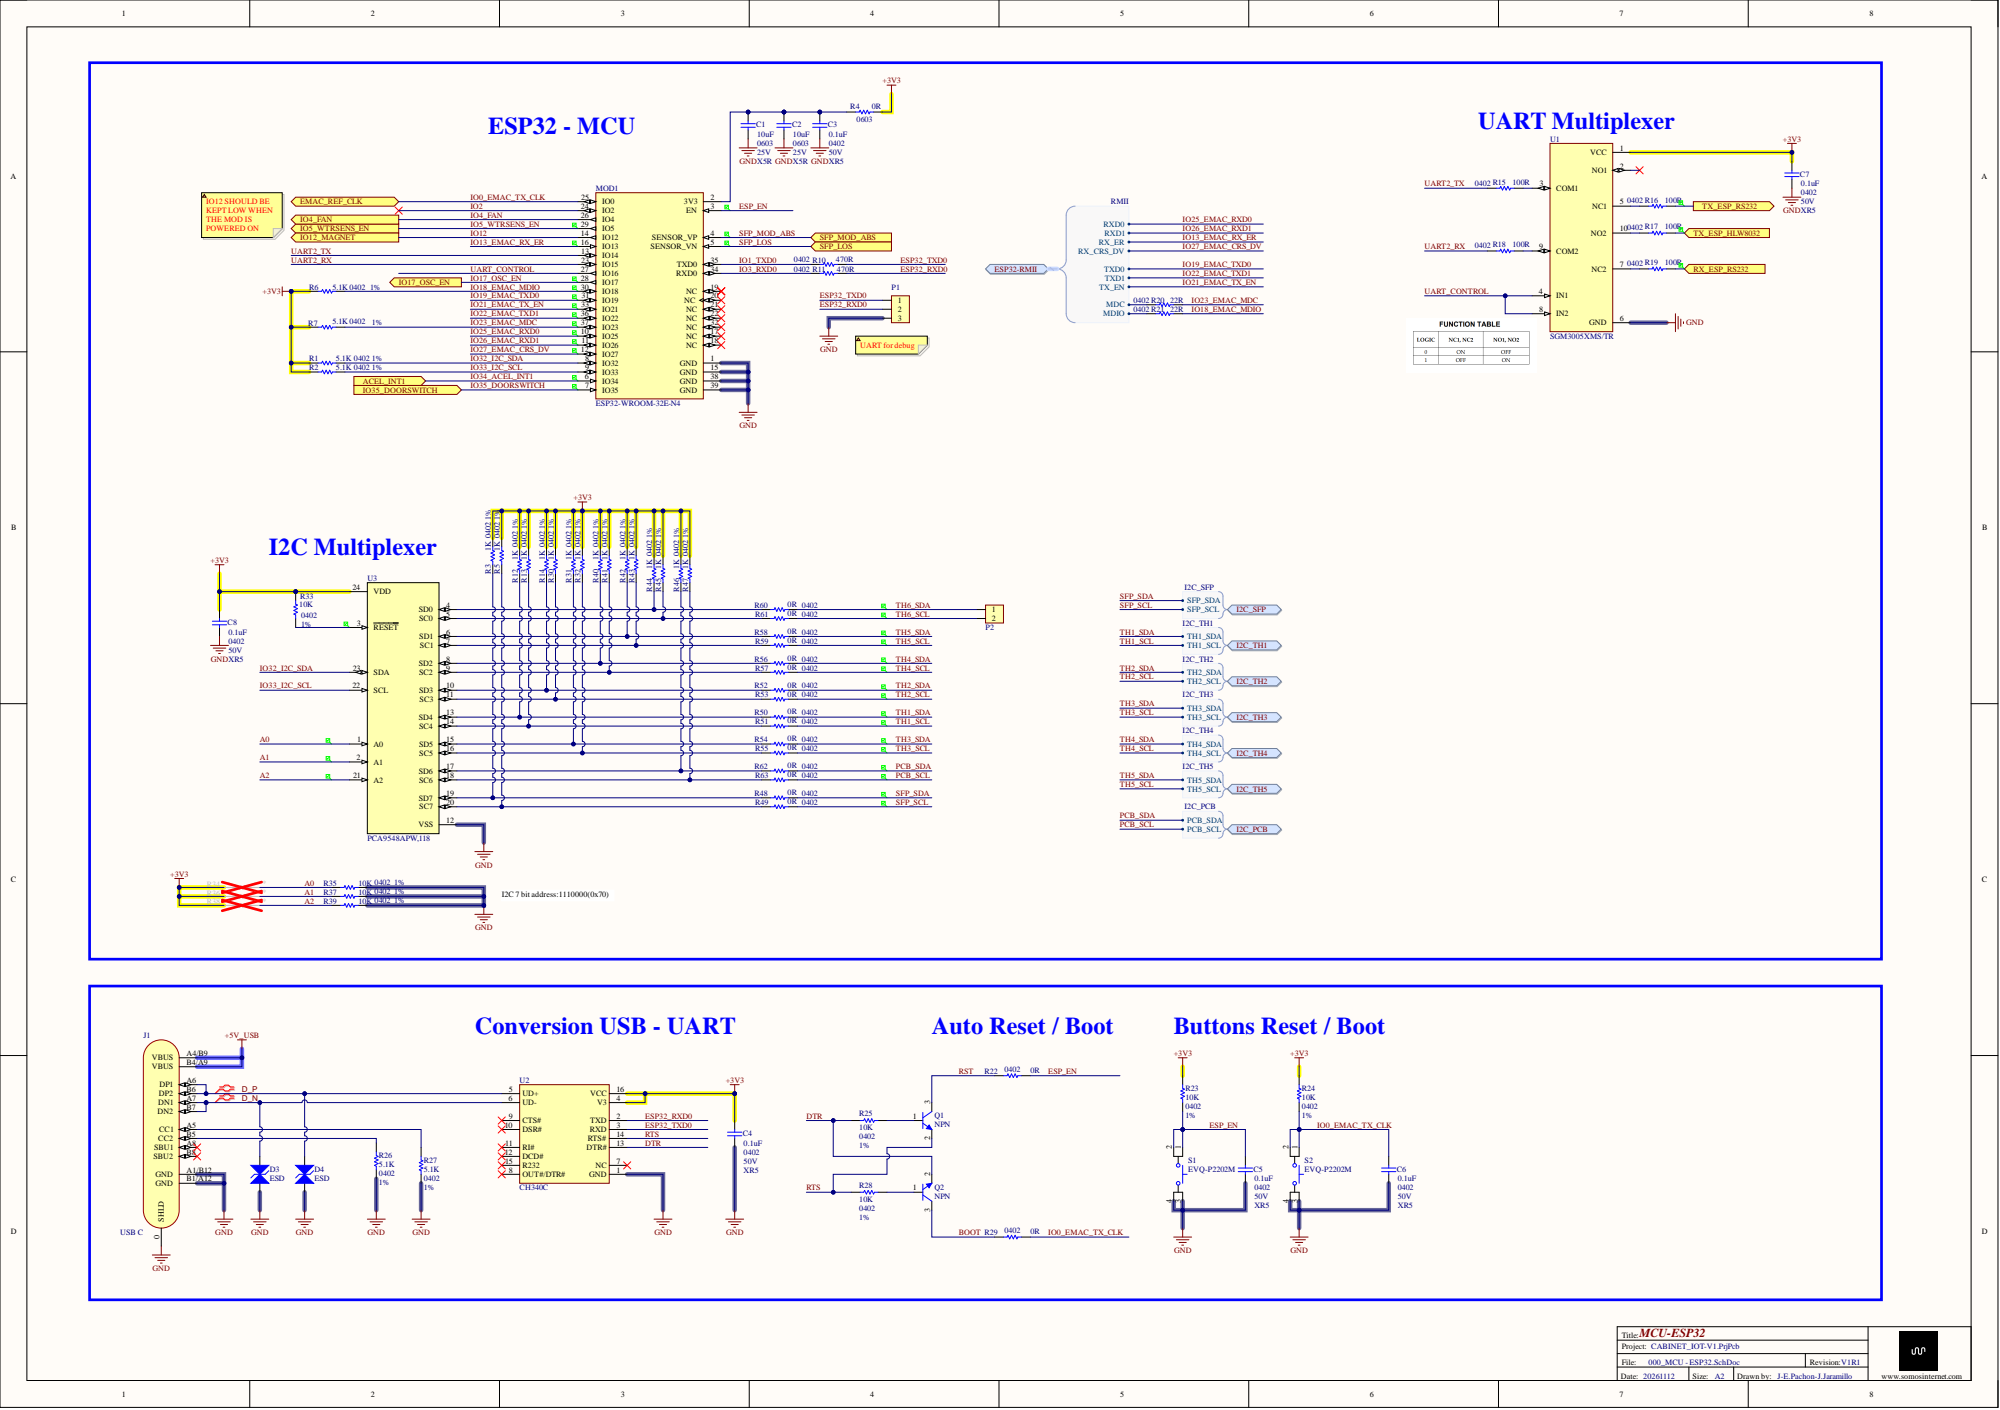
[picture p11: page 2]

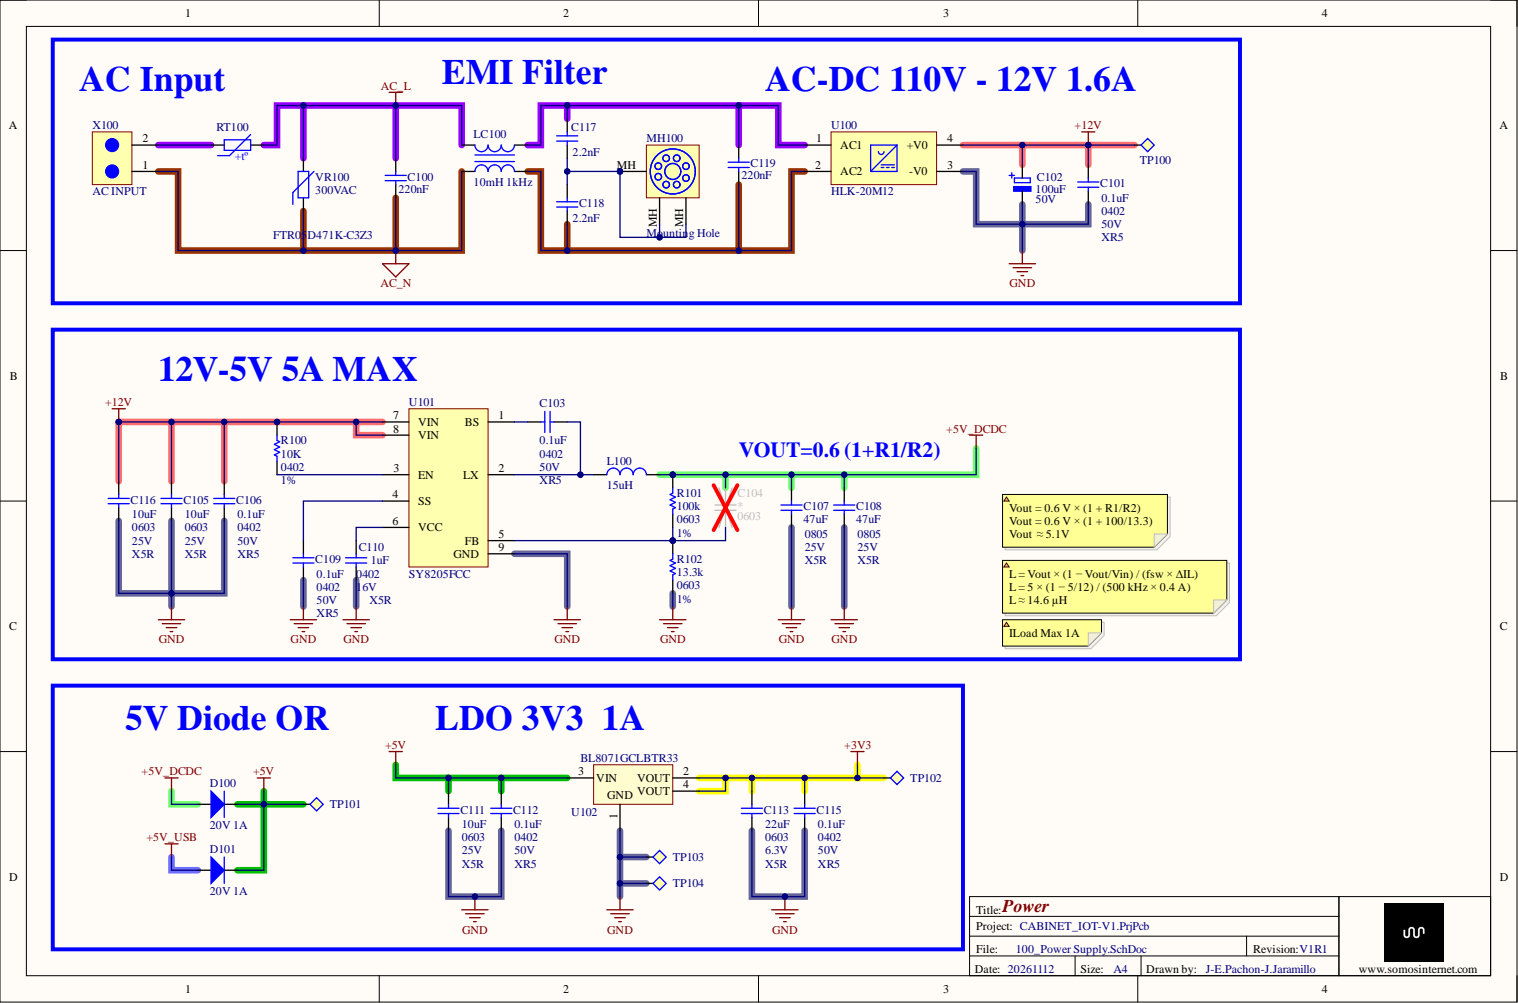
[picture p12: page 3]

R100 10K | VIN 8

L = Vout × (1 − Vout/Vin) / (fsw × ΔIL)
L = 5 × (1 − 5/12) / (500 kHz × 0.4 A)

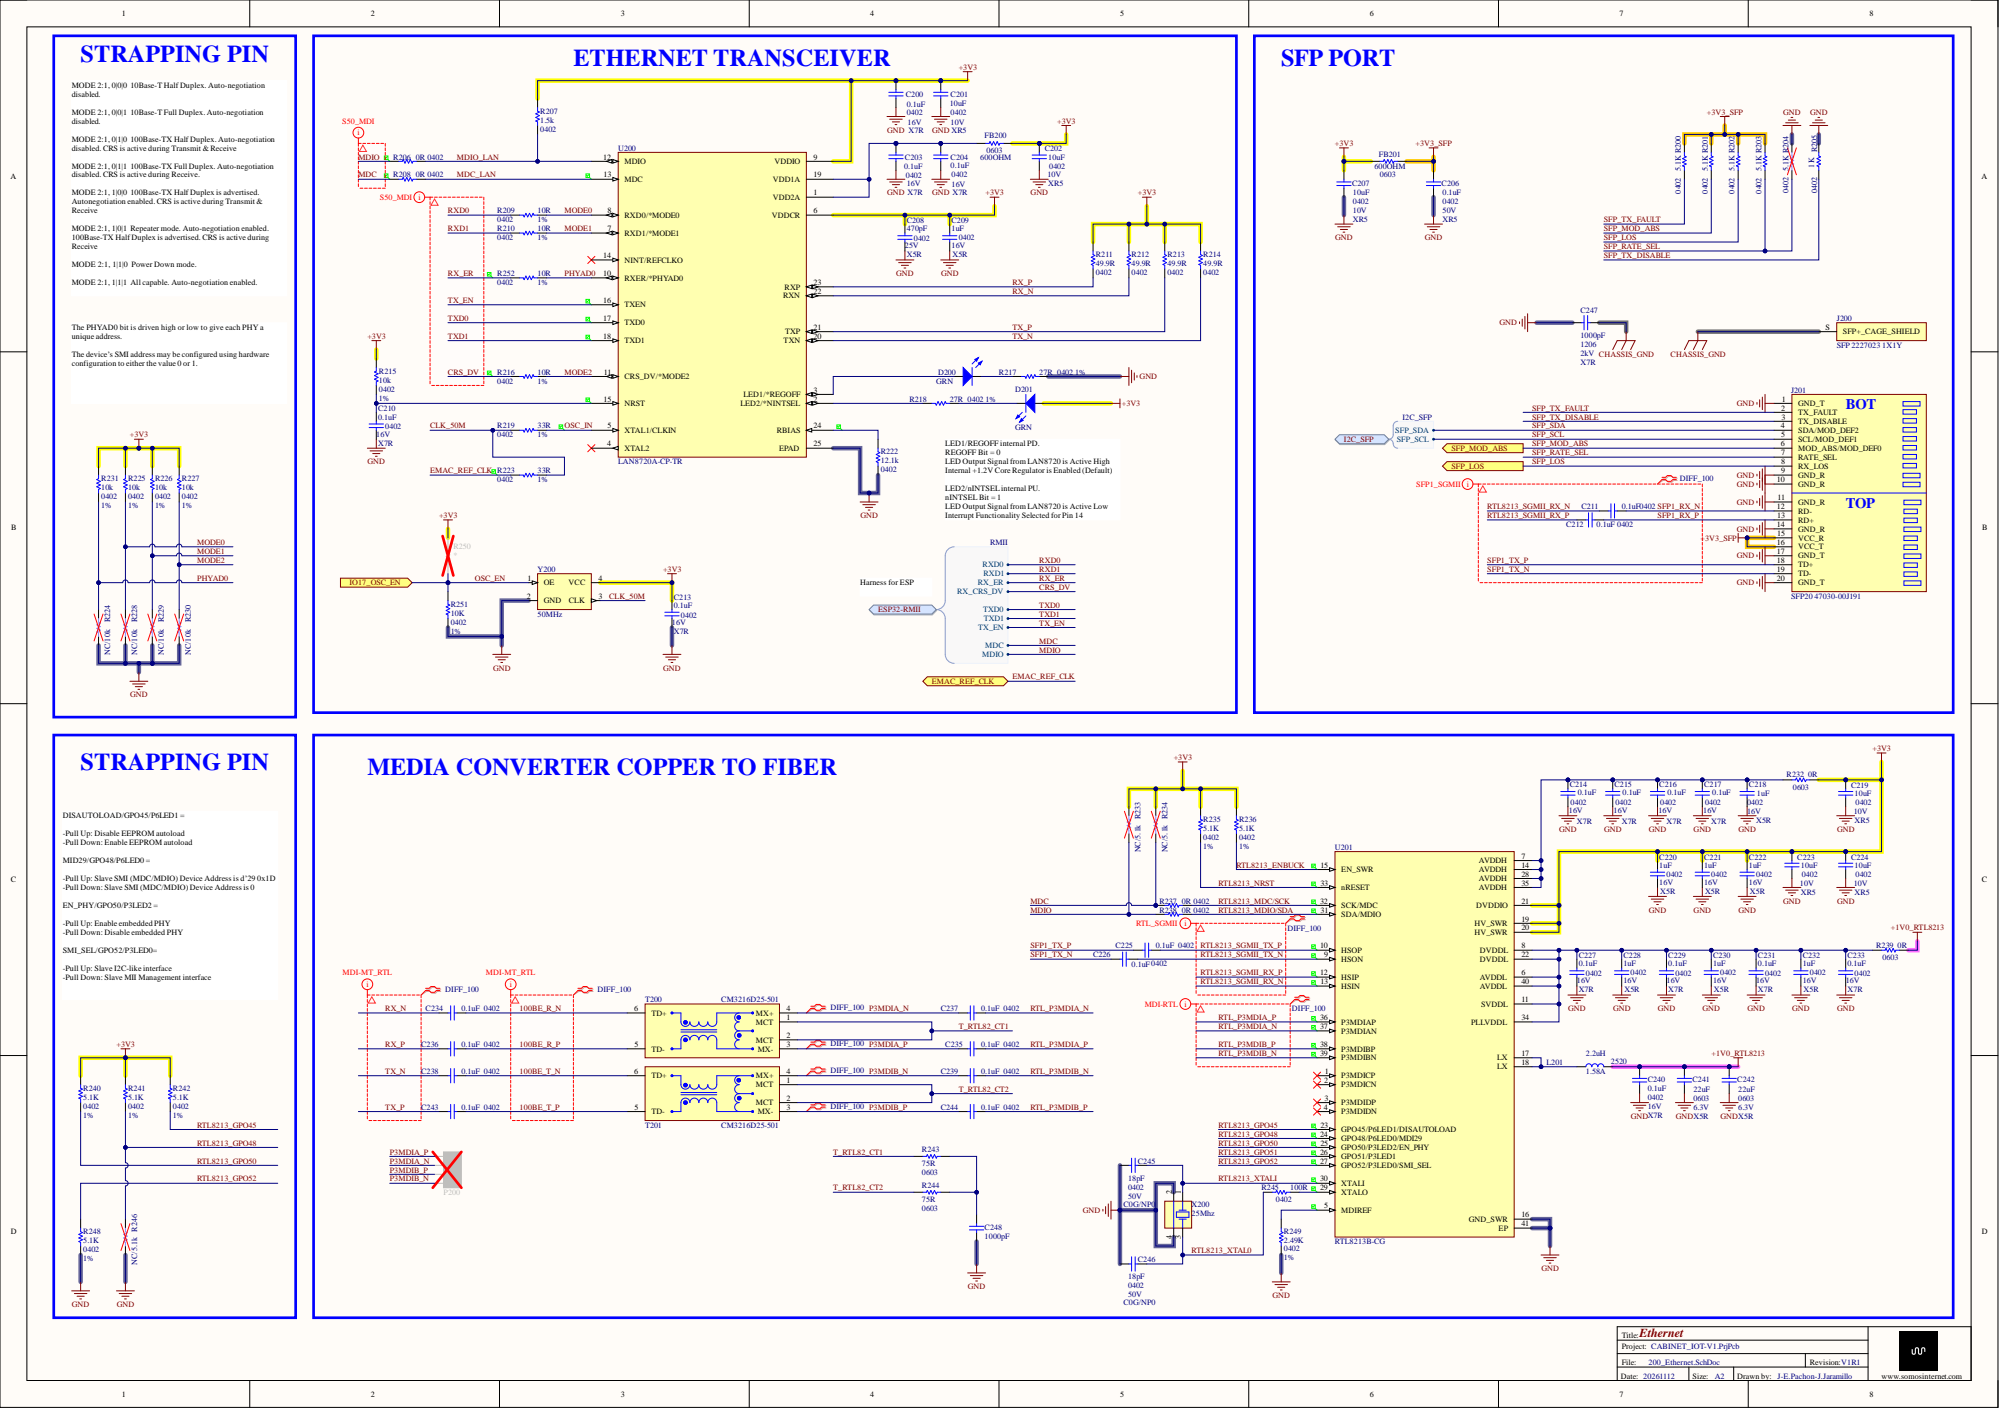
[picture p13: page 4]

MODE 2:1, 0|0|0 10Base-T Half Duplex. Auto-negotiation
disabled.

MODE 2:1, 0|0|1 10Base-T Full Duplex. Auto-negotiation

MODE 2:1, 0|1|0 100Base-TX Half Duplex. Auto-negotiation
disabled. CRS is active during Transmit & Receive

MODE 2:1, 0|1|1 100Base-TX Full Duplex. Auto-negotiation
disabled. CRS is active during Receive.

MODE 2:1, 1|0|0 100Base-TX Half Duplex is advertised.
Autonegotiation enabled. CRS is active during Transmit &
Receive

MODE 2:1, 1|0|1 Repeater mode. Auto-negotiation enabled.
100Base-TX Half Duplex is advertised. CRS is active during

MODE 2:1, 1|1|0 Power Down mode.

MODE 2:1, 1|1|1 All capable. Auto-negotiation enabled.

The PHYAD0 bit is driven high or low to give each PHY a
unique address.

The device’s SMI address may be configured using hardware
configuration to either the value 0 or 1.

LED1/REGOFF internal PD.
REGOFF Bit = 0
LED Output Signal from LAN8720 is Active High
Internal +1.2V Core Regulator is Enabled (Default)

LED2/nINTSELinternal PU.
nINTSEL Bit = 1
LED Output Signal from LAN8720 is Active Low
Interrupt Functionality Selected for Pin 14

MEDIA CONVERTER COPPER TO FIBER

-Pull Up: Disable EEPROM autoload
-Pull Down: Enable EEPROM autoload

-Pull Up: Slave SMI (MDC/MDIO) Device Address is d’29 0x1D
-Pull Down: Slave SMI (MDC/MDIO) Device Address is 0

-Pull Up: Enable embedded PHY
-Pull Down: Disable embedded PHY

-Pull Up: Slave I2C-like interface
-Pull Down: Slave MII Management interface

RX_P | 100BE_R_P | TD- 5
TX_N | | 100BE_T_N | RTL_P3MDIB_N | P3MDIBN 39

RTL_P3MDIB_P | P3MDIBP 38

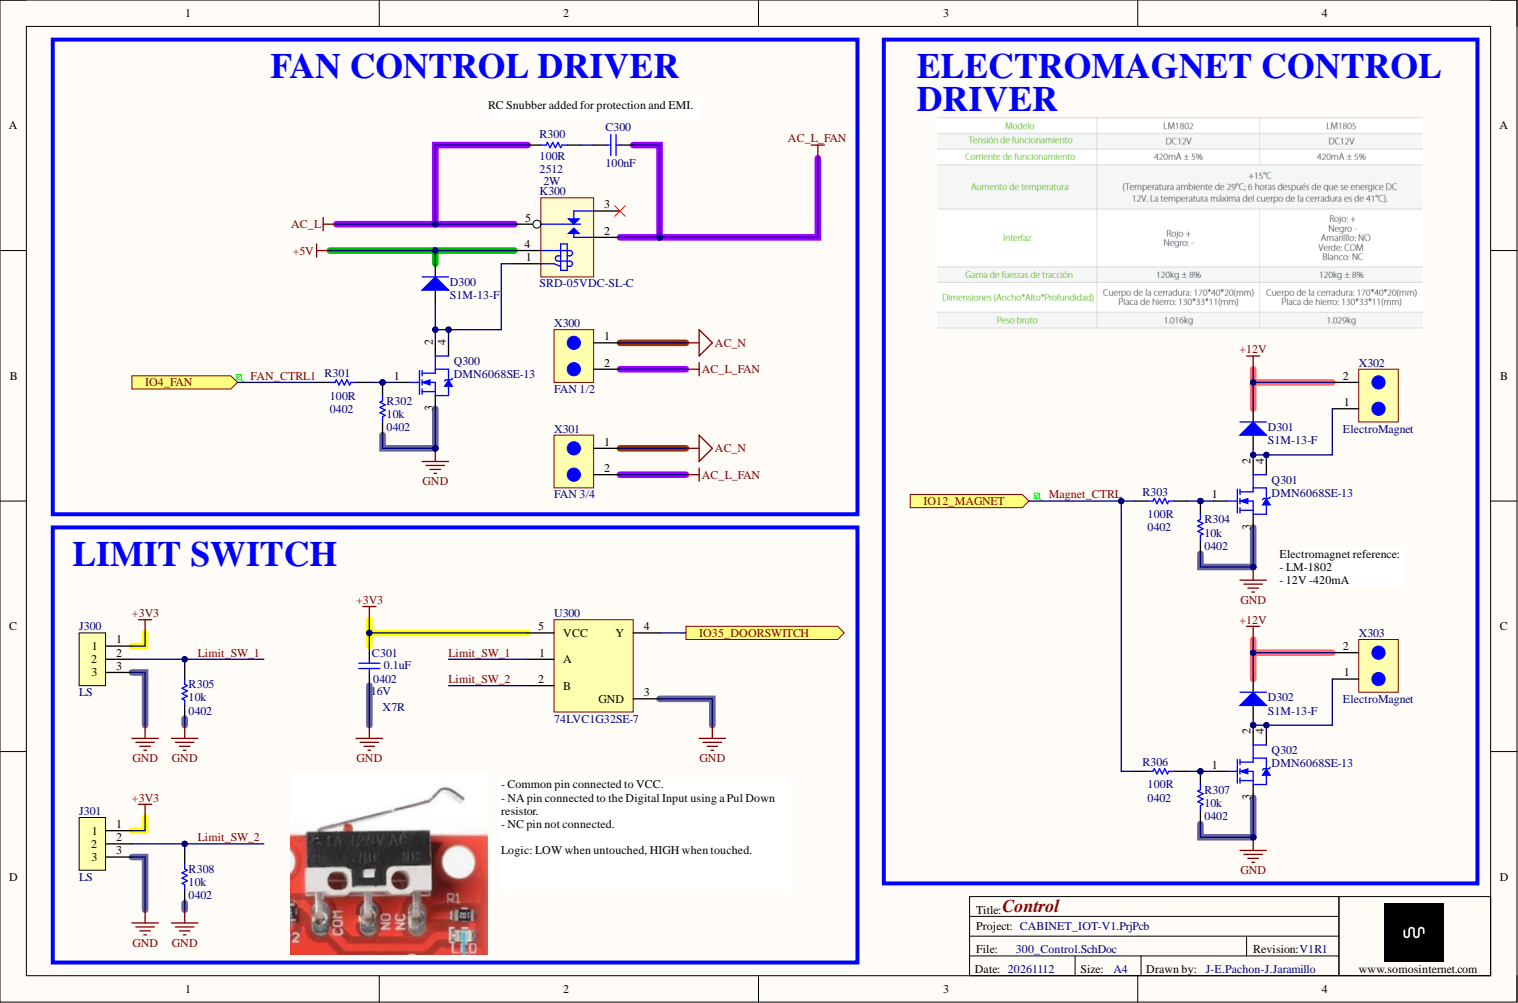
[picture p14: page 5]

FAN CONTROL DRIVER RC Snubber added for protection and EMI.

- Common pin connected to VCC.
- NA pin connected to the Digital Input using a Pul Down
resistor.
- NC pin not connected.

Logic: LOW when untouched, HIGH when touched.

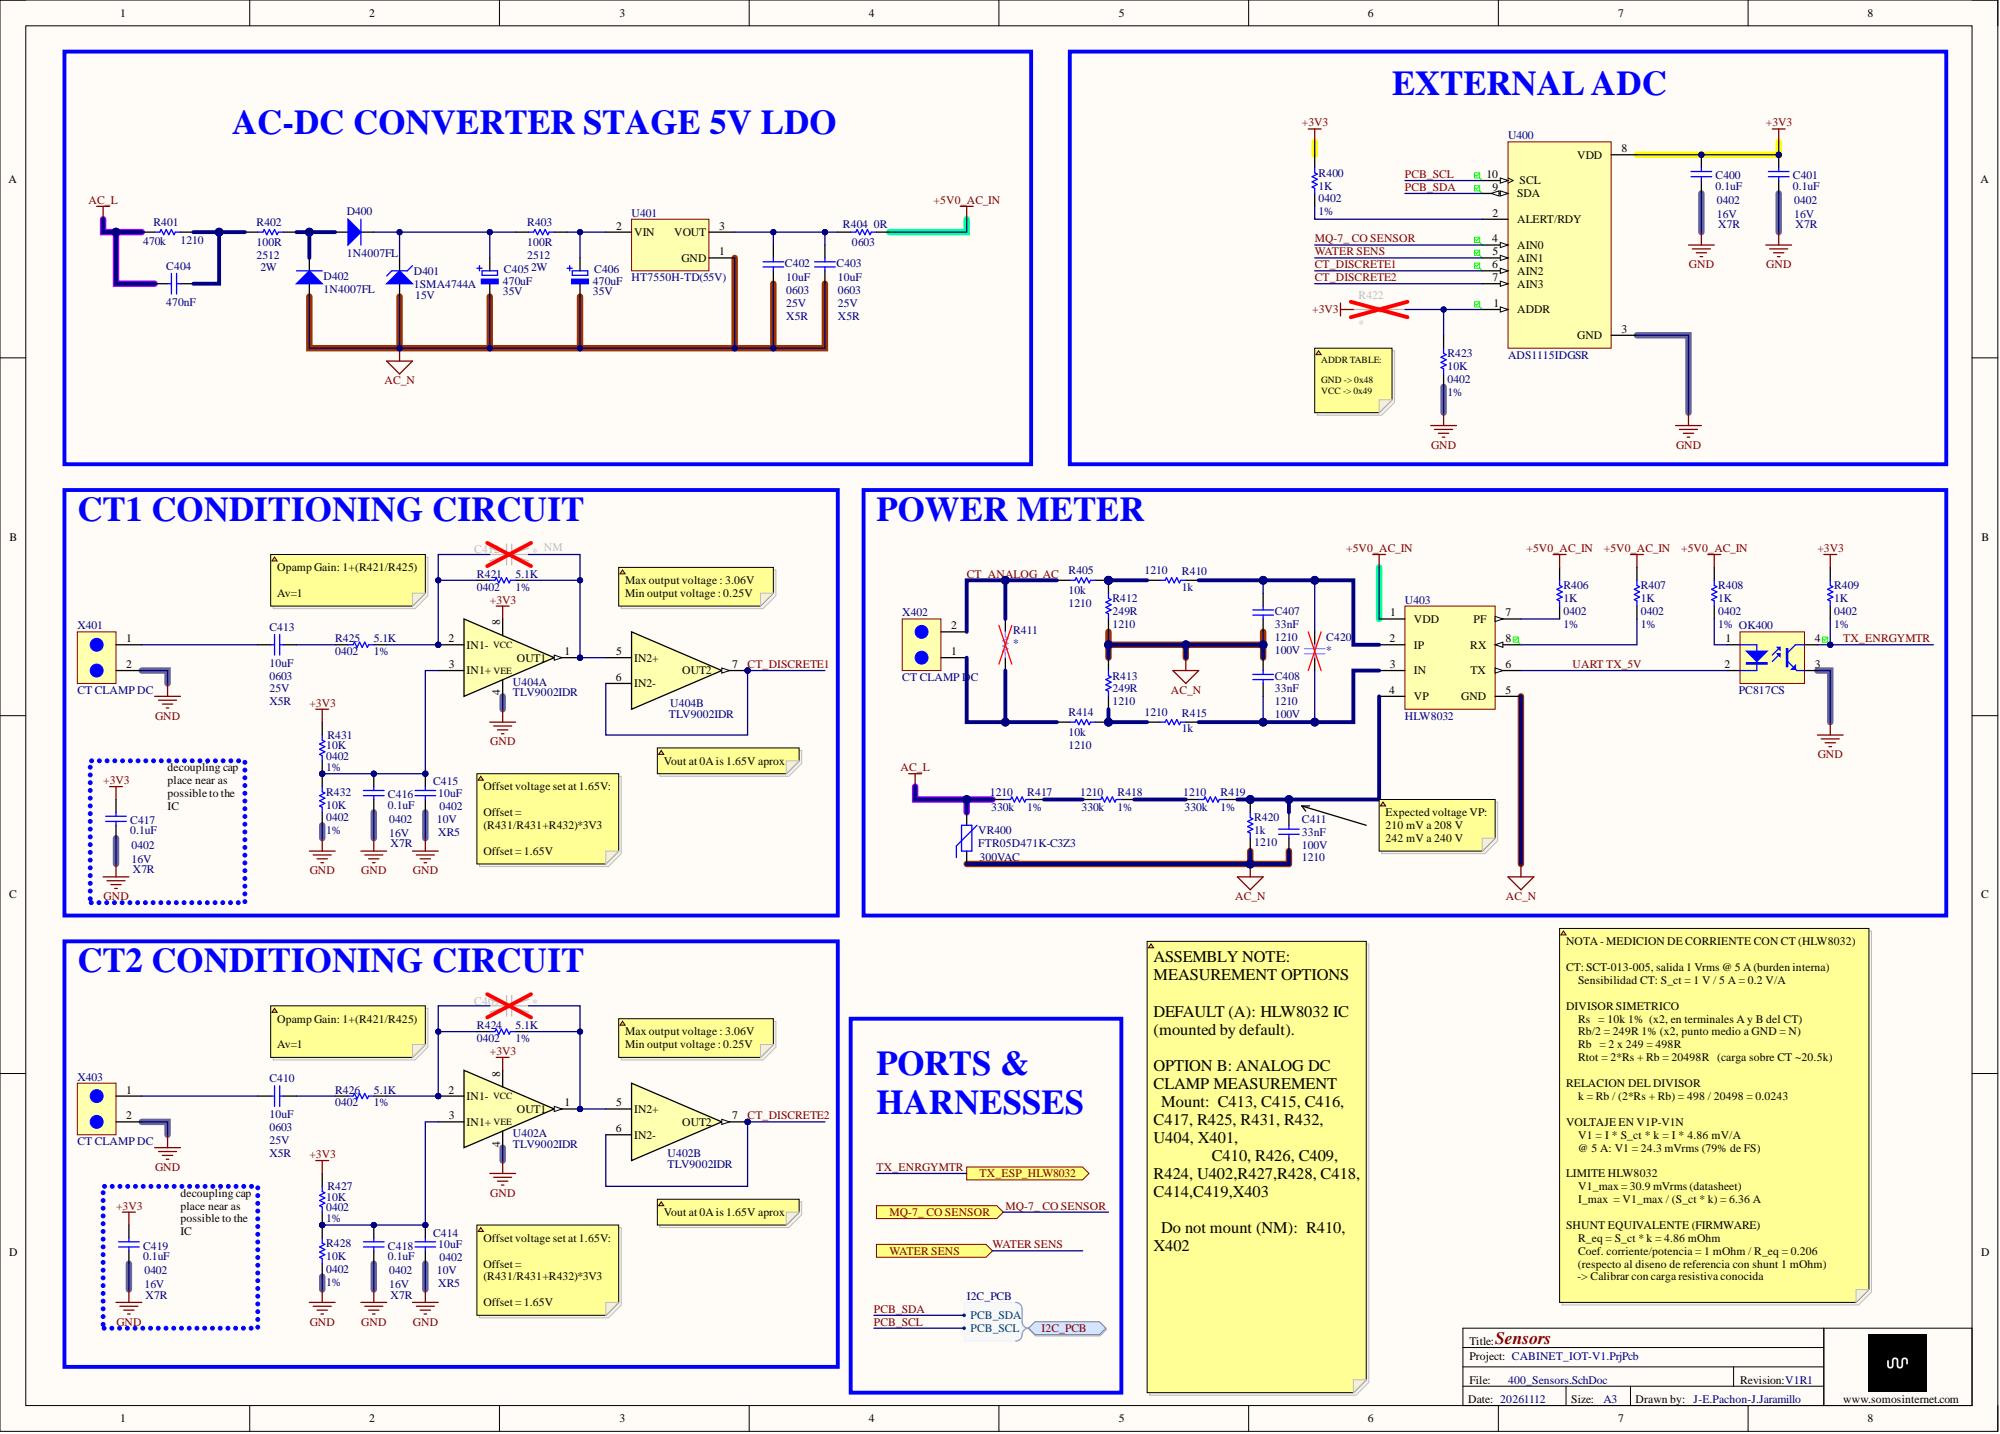
[picture p15: page 6]

AC-DC CONVERTER STAGE 5V LDO

Vout at 0A is 1.65V aprox

Offset voltage set at 1.65V:

NOTA - MEDICION DE CORRIENTE CON CT (HLW8032)

CT: SCT-013-005, salida 1 Vrms @ 5 A (burden interna)
Sensibilidad CT: S_ct = 1 V / 5 A = 0.2 V/A

DIVISOR SIMETRICO
Rs = 10k 1% (x2, en terminales A y B del CT)
Rb/2 = 249R 1% (x2, punto medio a GND = N)
Rtot = 2*Rs + Rb = 20498R (carga sobre CT ~20.5k)

Do not mount (NM): R410,

SHUNT EQUIVALENTE (FIRMWARE)
R_eq = S_ct * k = 4.86 mOhm
Coef. corriente/potencia = 1 mOhm / R_eq = 0.206
(respecto al diseno de referencia con shunt 1 mOhm)
-> Calibrar con carga resistiva conocida

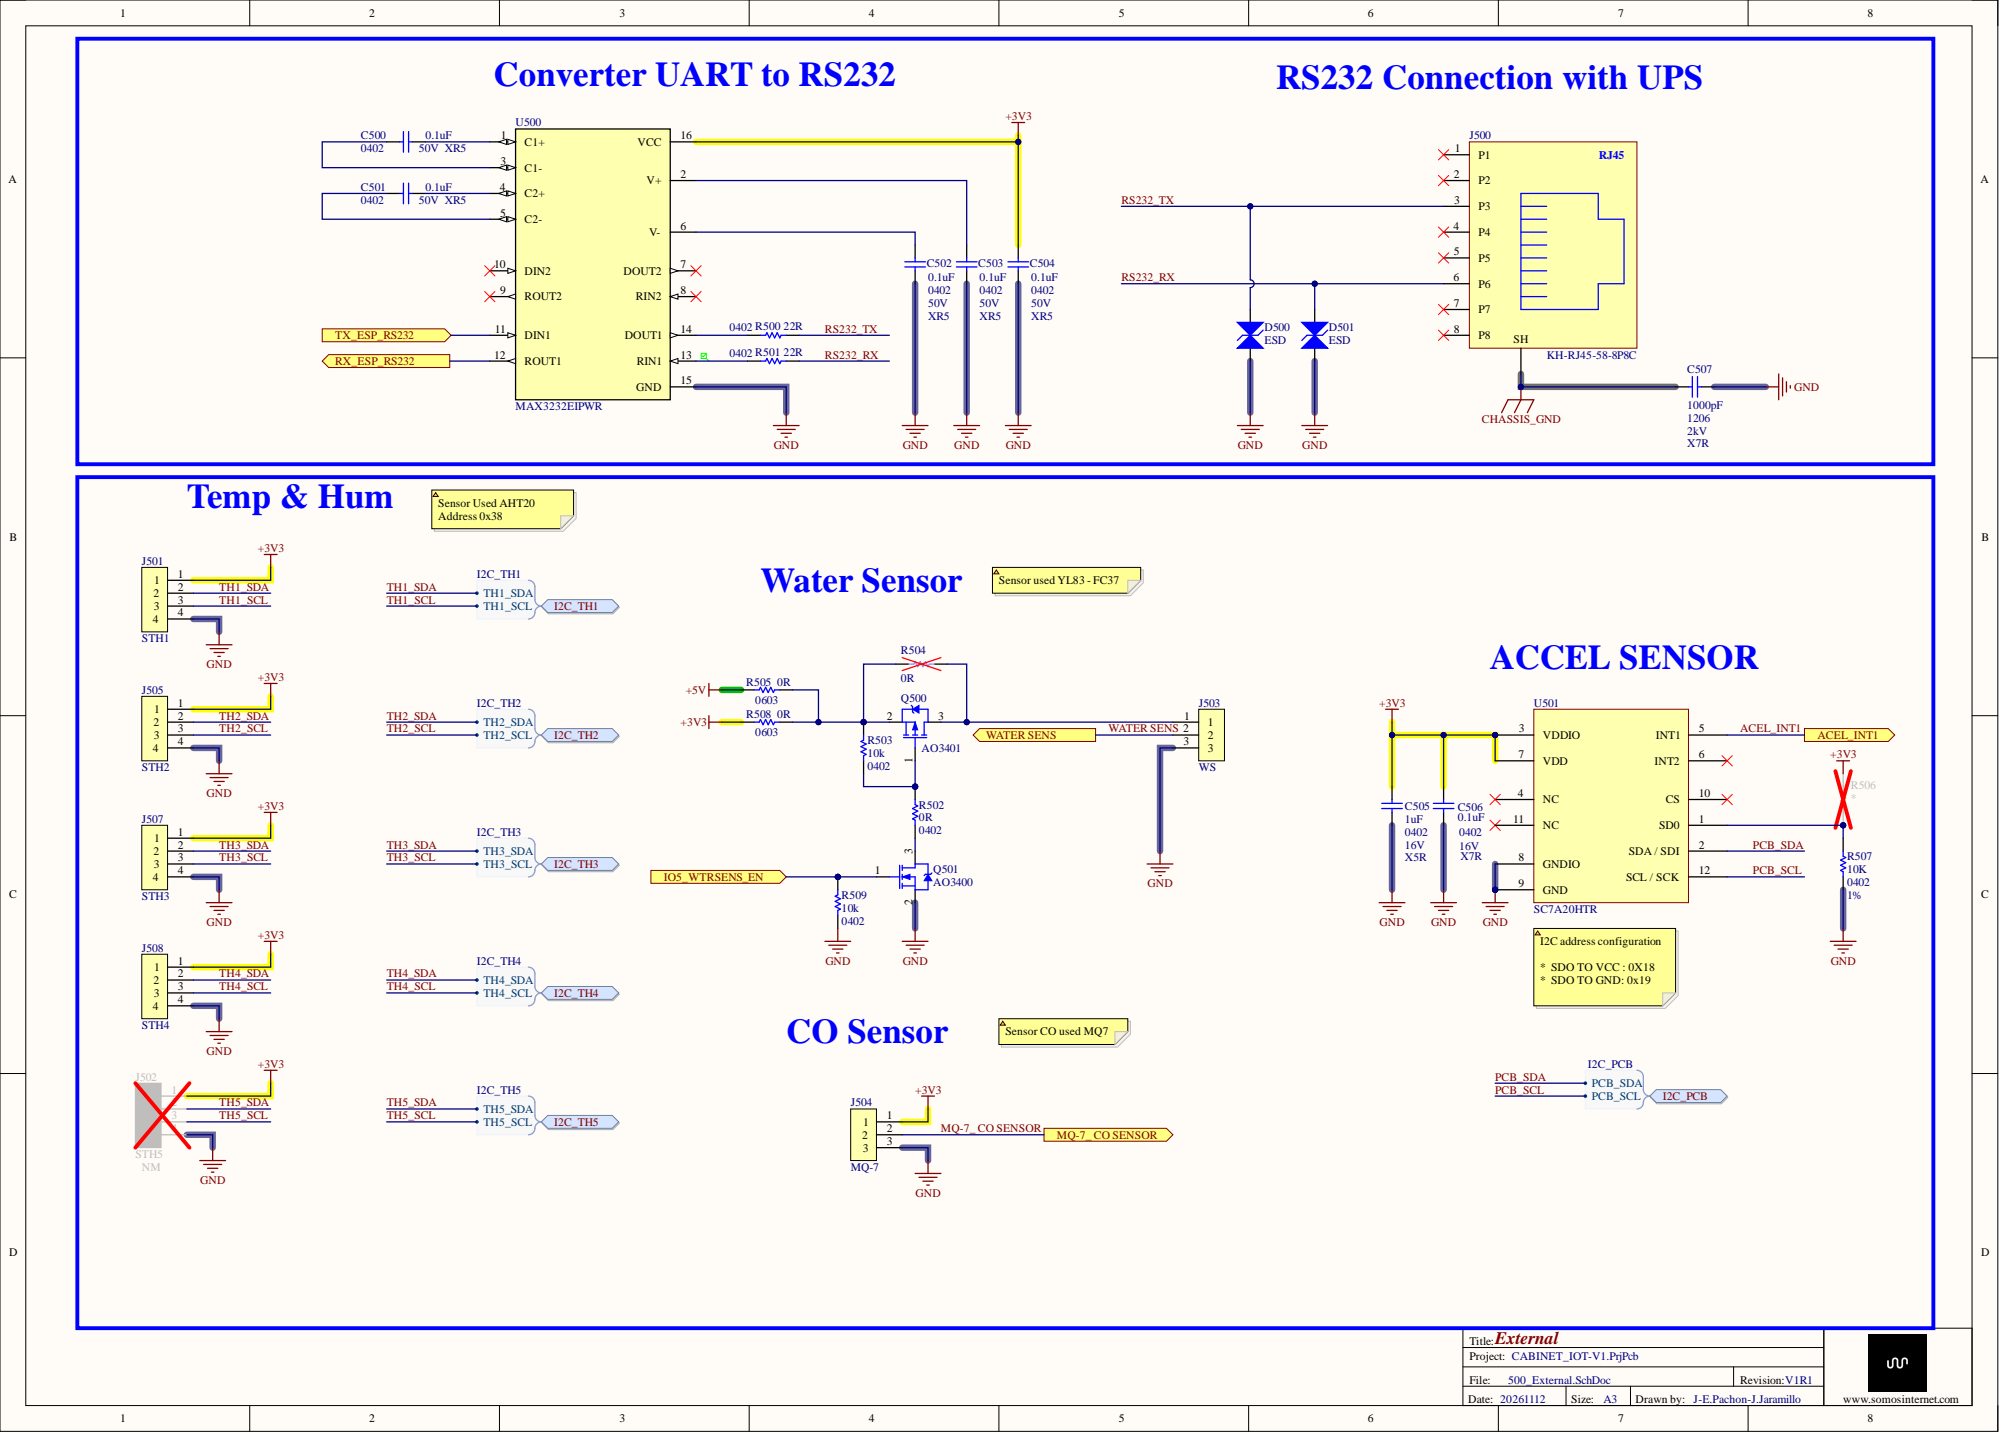
[picture p16: page 7]
