SOMOS-HARDWARE-DESIGN/PRJ_CABINET_IOT/Manufacturing files/V1R1/PCB MFG-ASY-SCH PDF/PCB_ASSY_PDF_CABINET-IOT_1.1.20261112.pdf

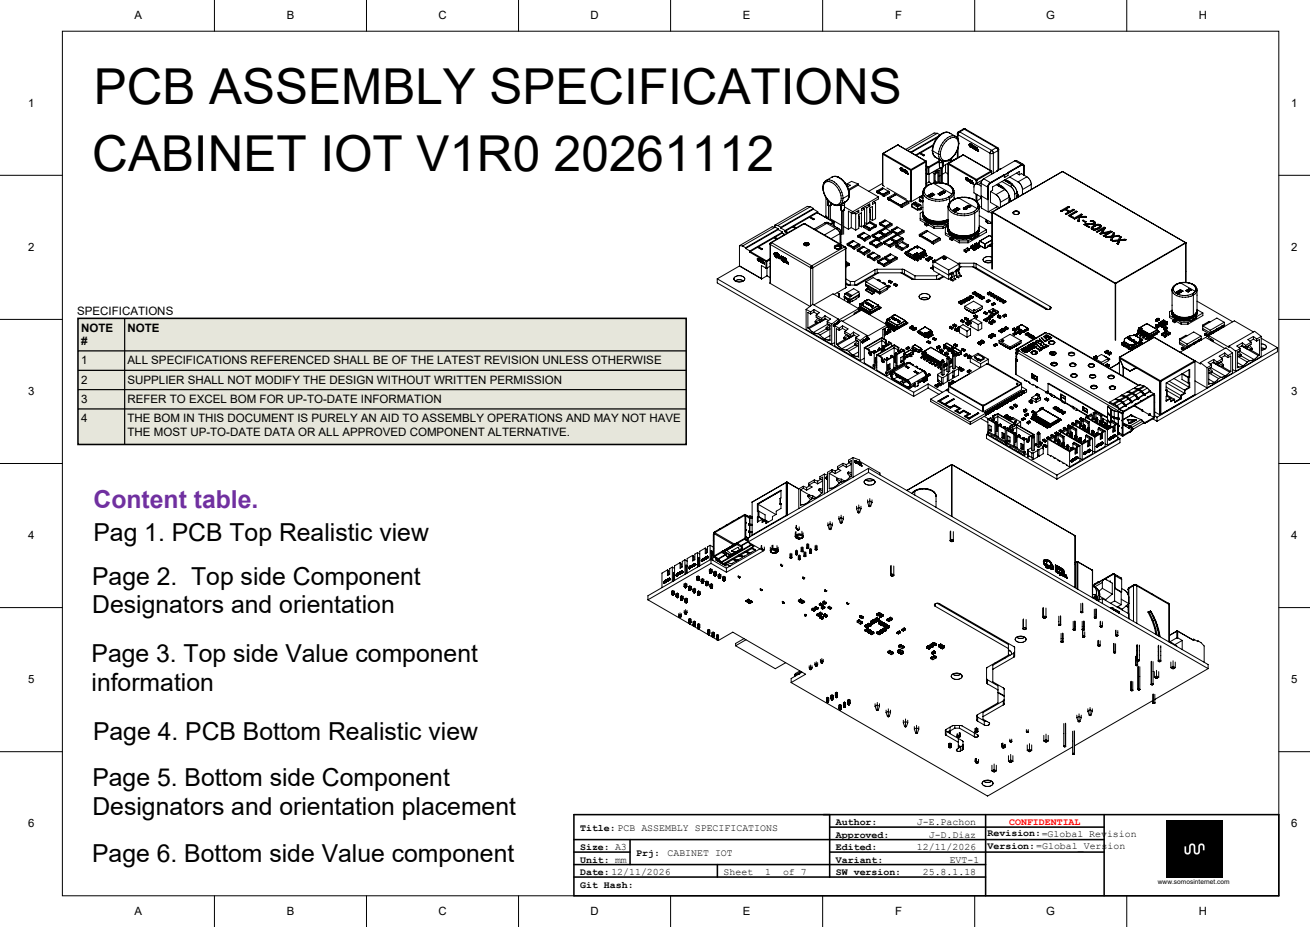
[picture p17: page 1]

NOTE # | NOTE

1 | ALL SPECIFICATIONS REFERENCED SHALL BE OF THE LATEST REVISION UNLESS OTHERWISE
2 | SUPPLIER SHALL NOT MODIFY THE DESIGN WITHOUT WRITTEN PERMISSION
3 | REFER TO EXCEL BOM FOR UP-TO-DATE INFORMATION
4 | THE BOM IN THIS DOCUMENT IS PURELY AN AID TO ASSEMBLY OPERATIONS AND MAY NOT HAVE THE MOST UP-TO-DATE DATA OR ALL APPROVED COMPONENT ALTERNATIVE.

Content table.
Pag 1. PCB Top Realistic view
Page 2. Top side Component
Designators and orientation
Page 3. Top side Value component
information
Page 4. PCB Bottom Realistic view
Page 5. Bottom side Component
Designators and orientation placement
Page 6. Bottom side Value component

Title: PCB ASSEMBLY SPECIFICATIONS | Author: J-E.Pachon | CONFIDENTIAL | www.somosinternet.com

Approved: J-D.Diaz | Revision: =Global_Revision

Size: A3 | Prj: CABINET IOT | Edited: 12/11/2026 | Version: =Global_Version
Unit: mm | | Variant: EVT-1
Date:12/11/2026 | Sheet 1 of 7 | SW version: 25.8.1.18

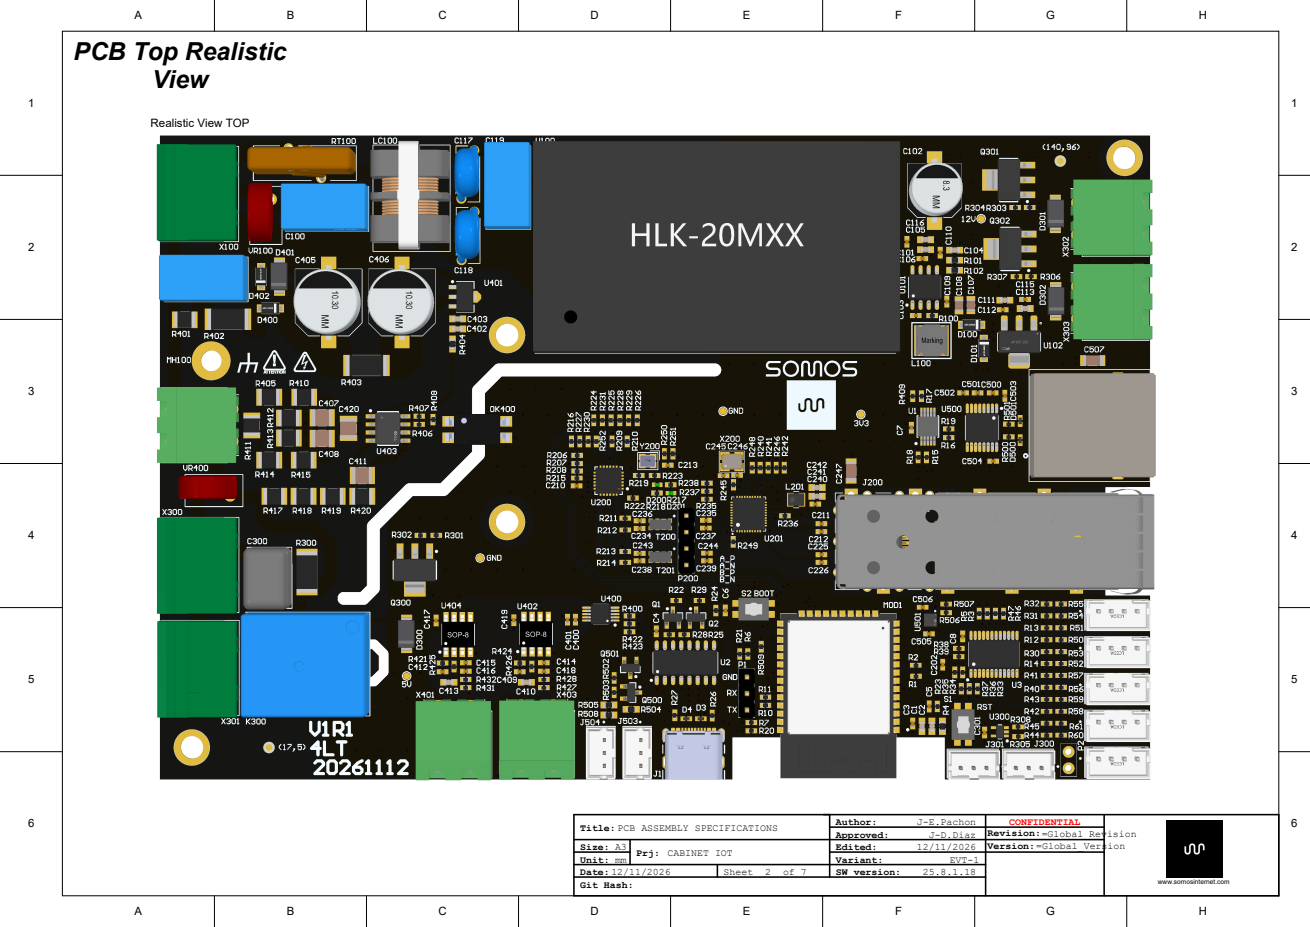
[picture p18: page 2]

Title: PCB ASSEMBLY SPECIFICATIONS | Author: J-E.Pachon | CONFIDENTIAL

Approved: J-D.Diaz | Revision: =Global_Revision

Size: A3 | | Edited: 12/11/2026 | Version: =Global_Version

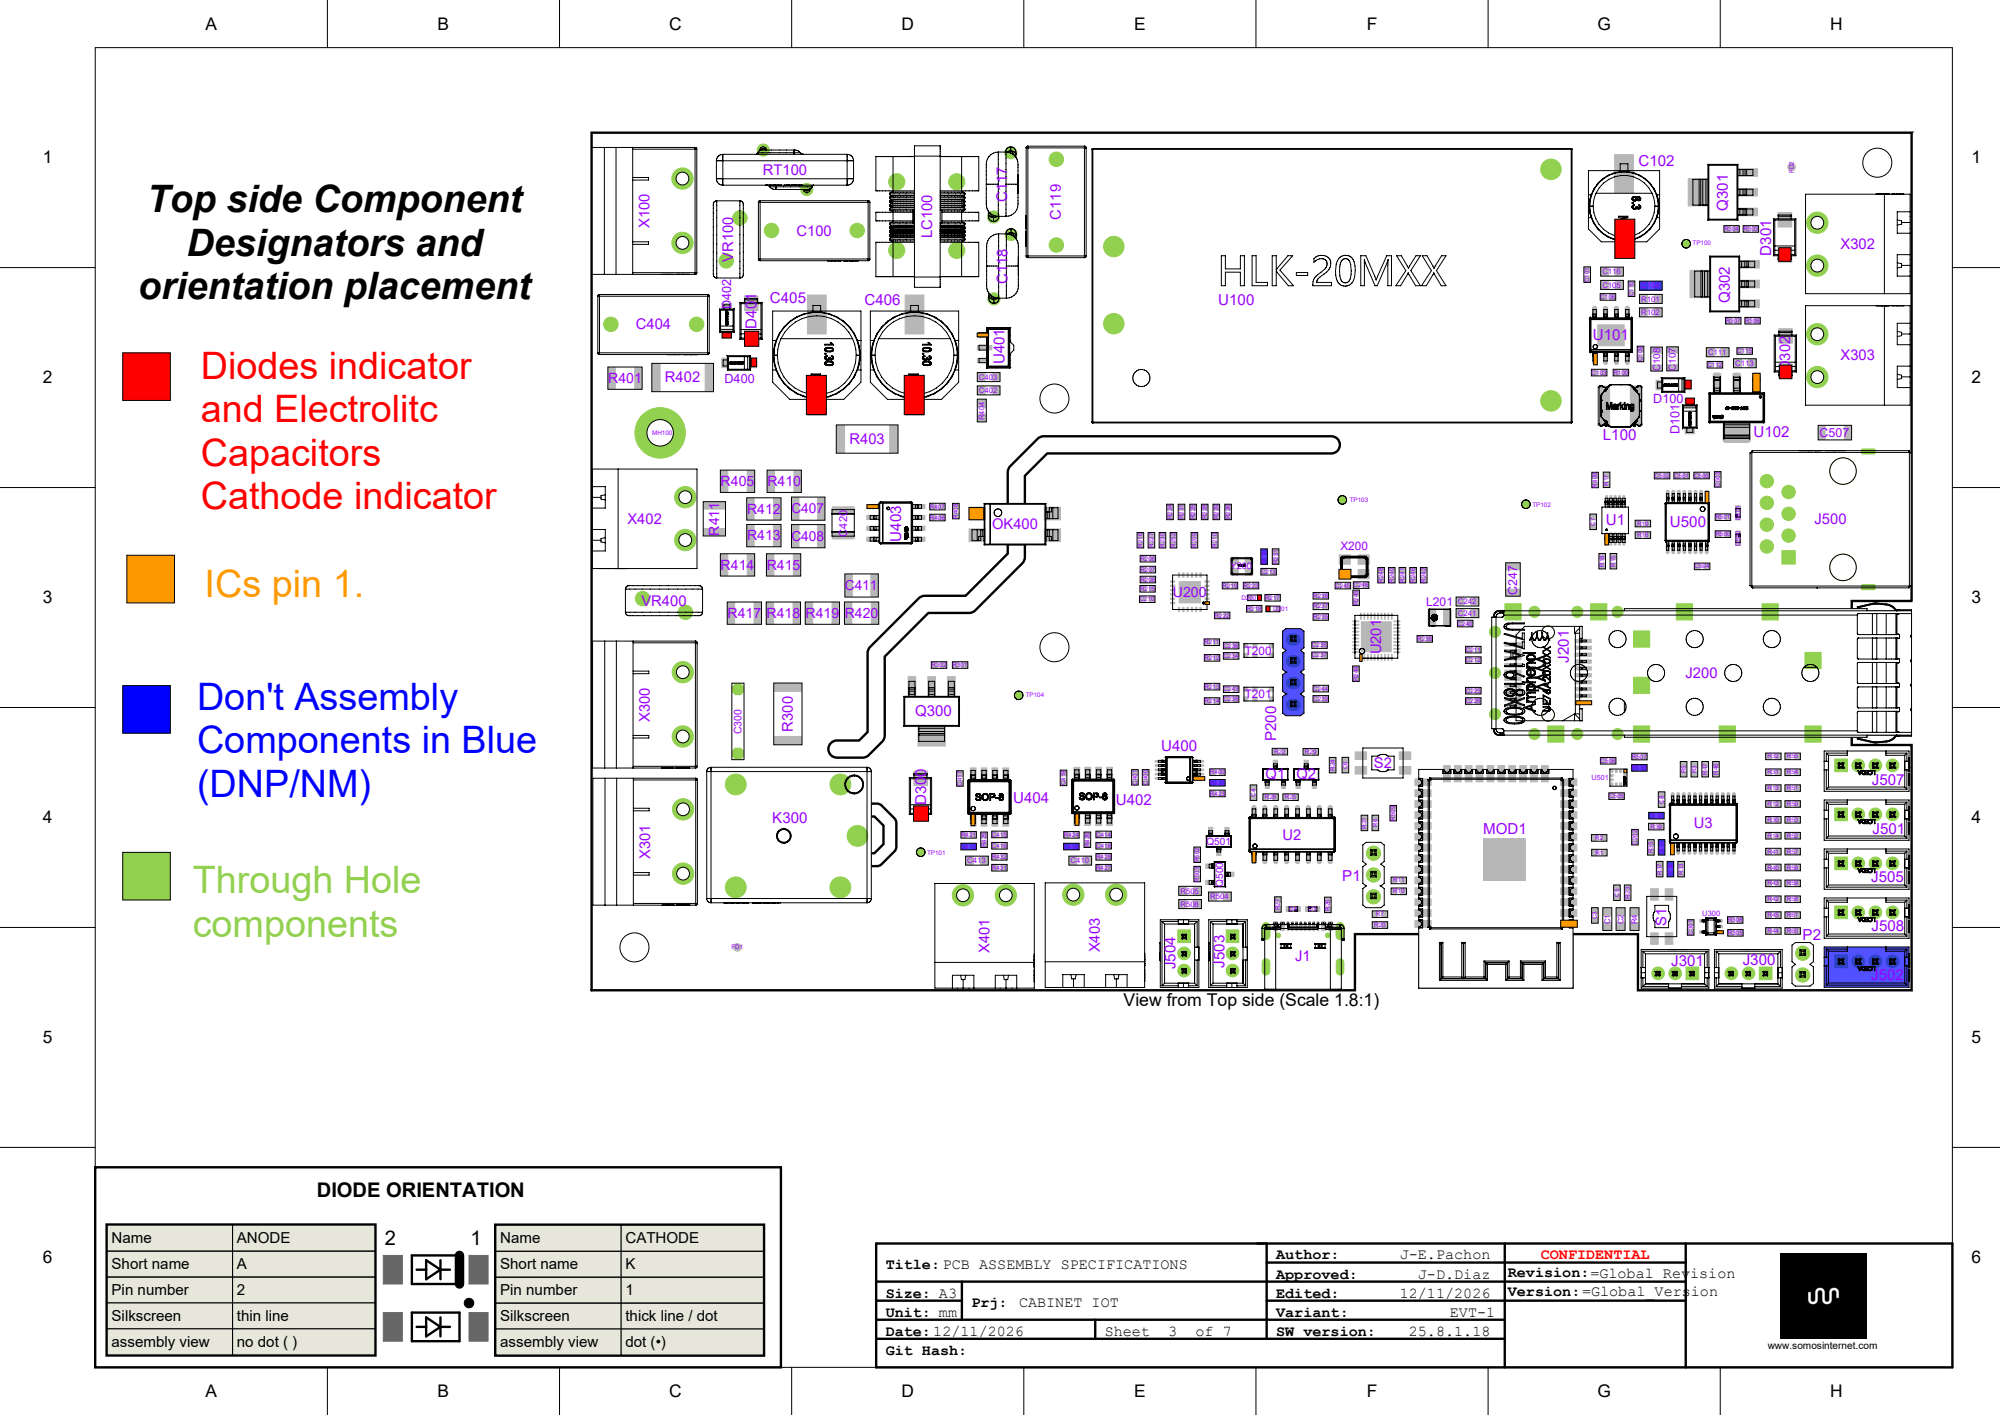
[picture p19: page 3]

View from Top side (Scale 1.8:1)

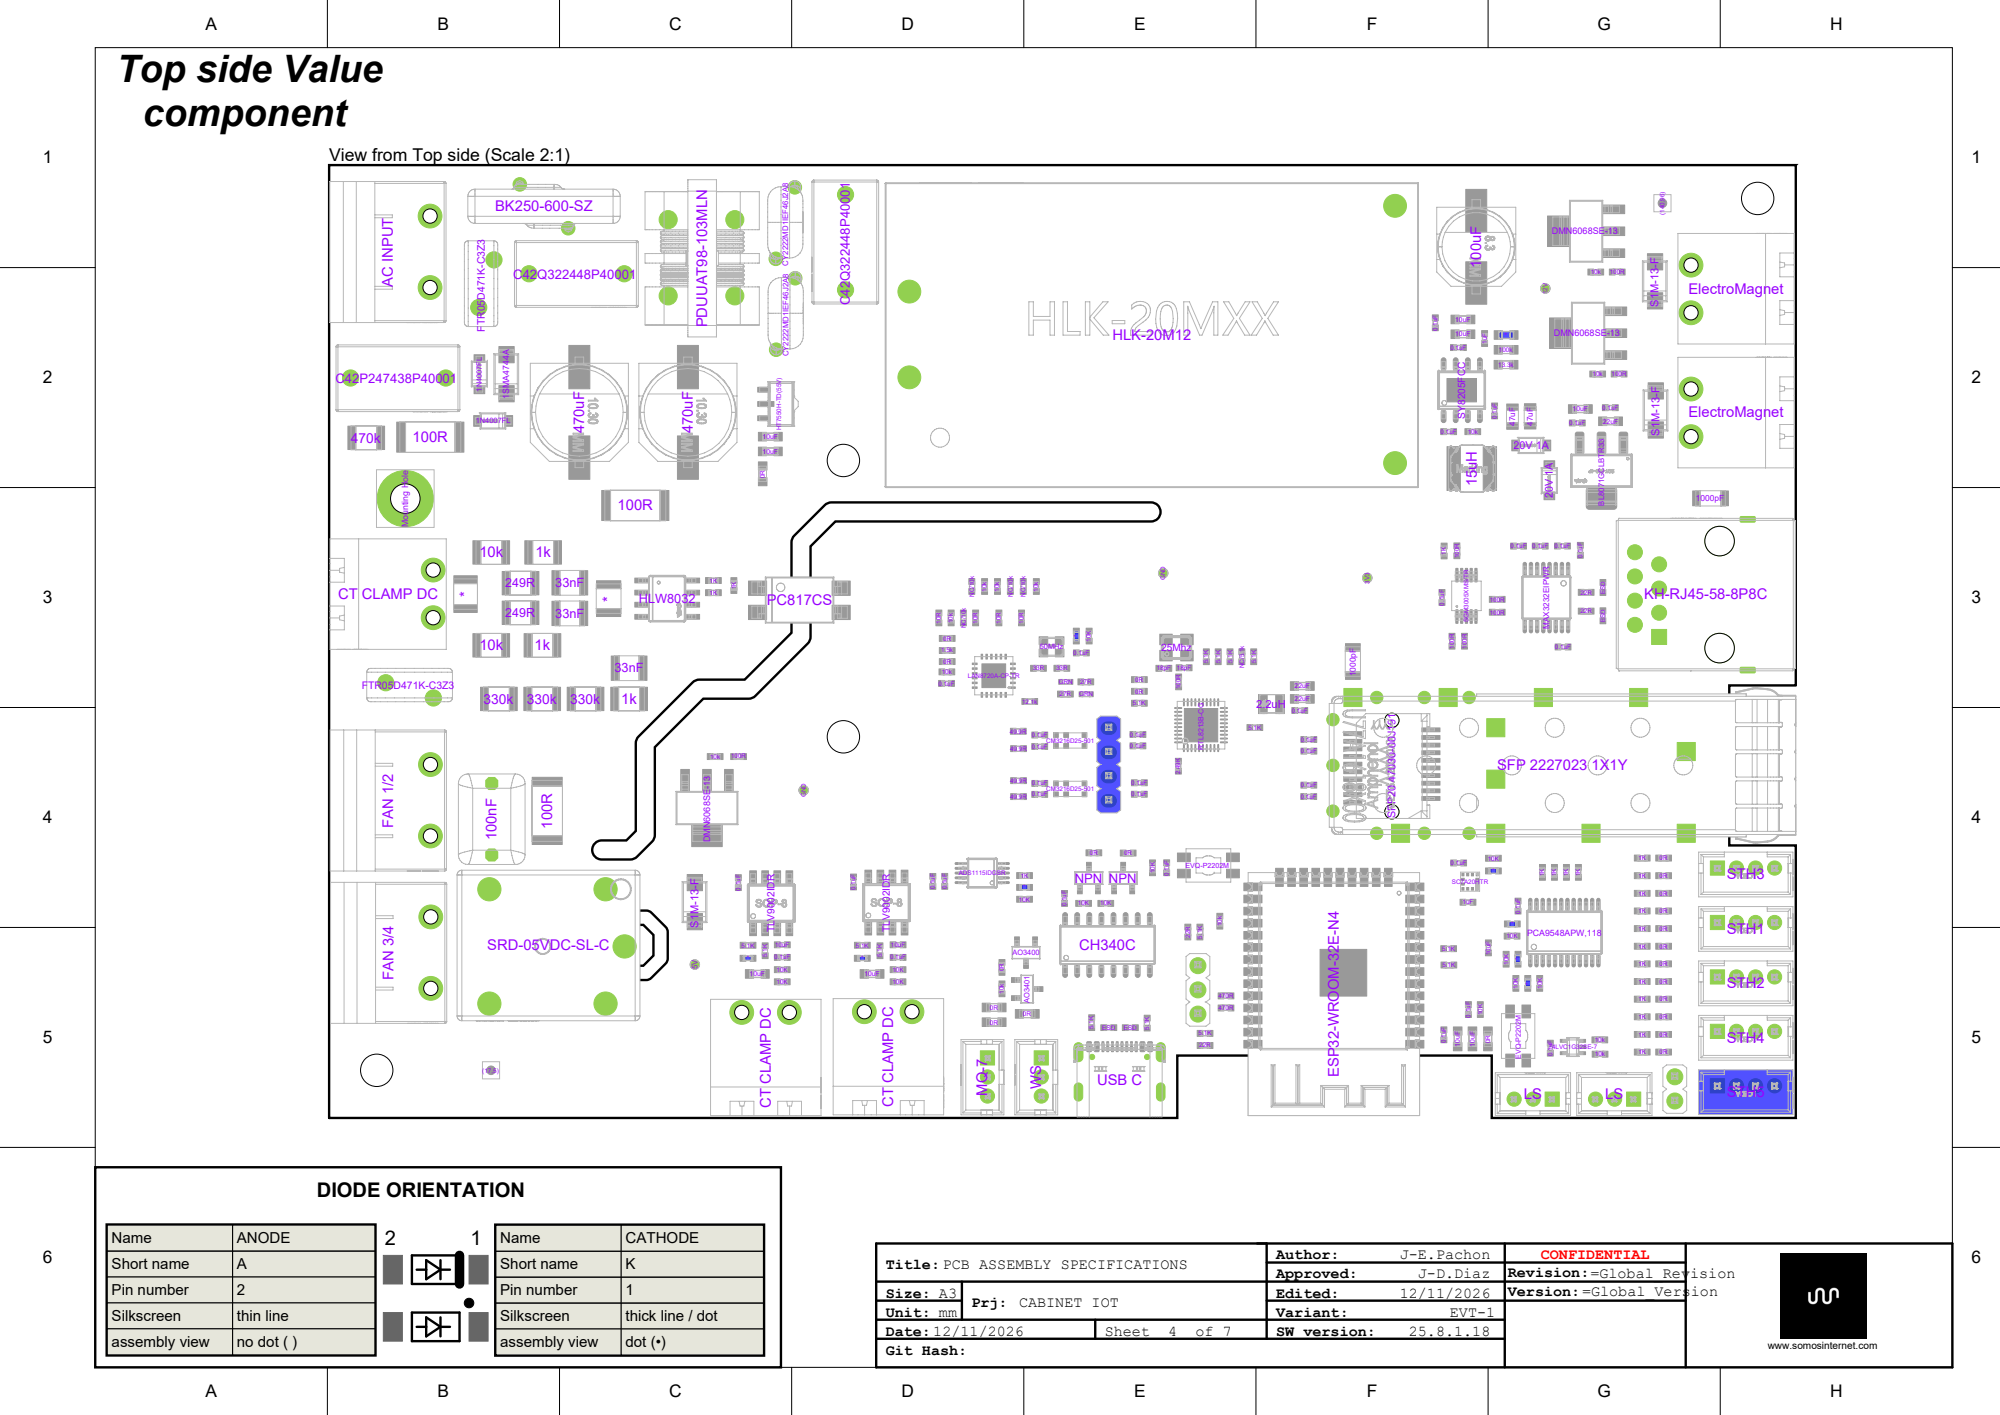
[picture p20: page 4]

View from Top side (Scale 2:1)

FAN 3/4 FAN 1/2 AC INPUT

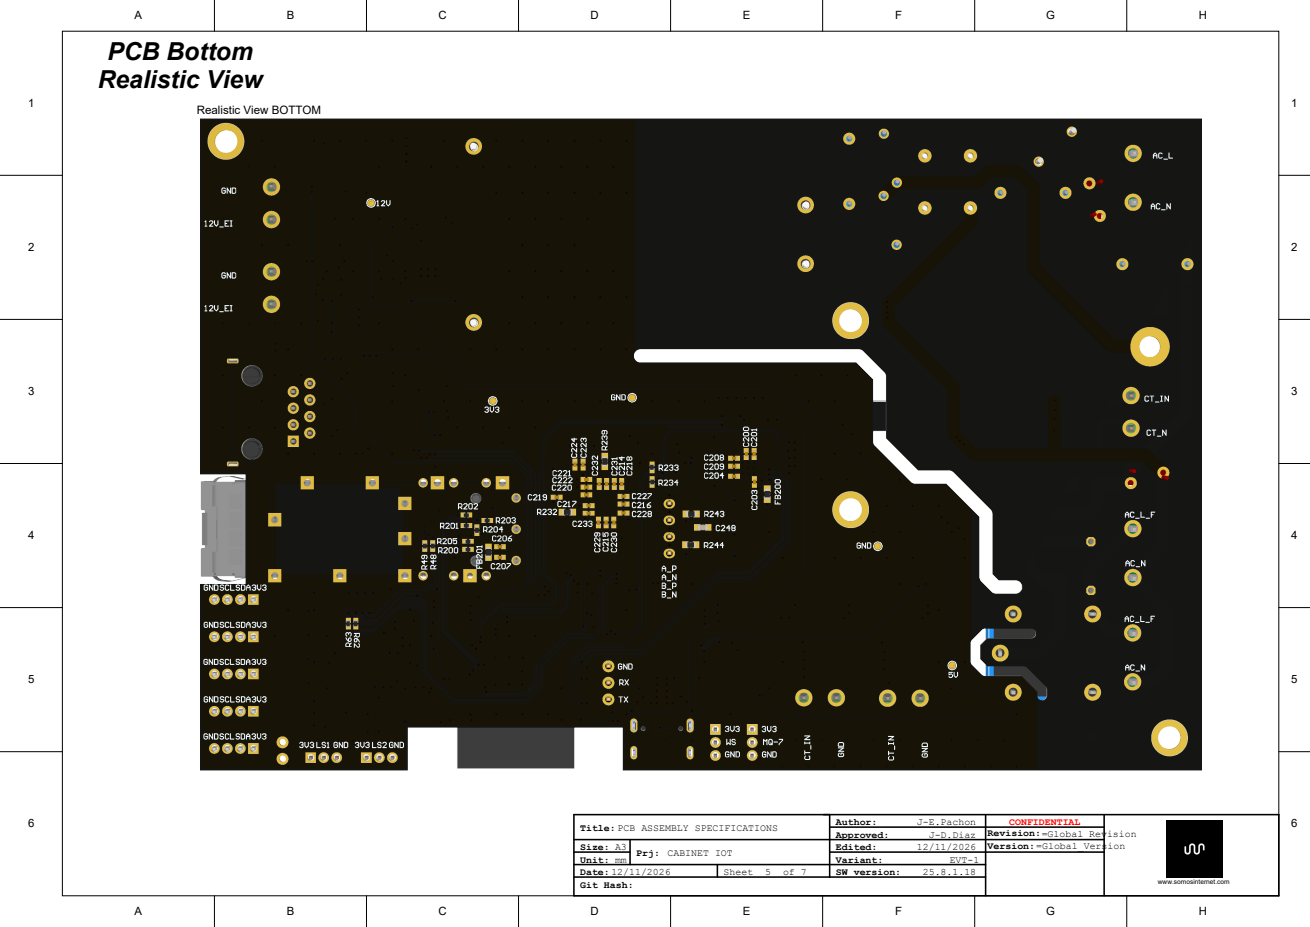
[picture p21: page 5]

Title: PCB ASSEMBLY SPECIFICATIONS | Author: J-E.Pachon | CONFIDENTIAL

Approved: J-D.Diaz | Revision: =Global_Revision

Size: A3 | | Edited: 12/11/2026 | Version: =Global_Version

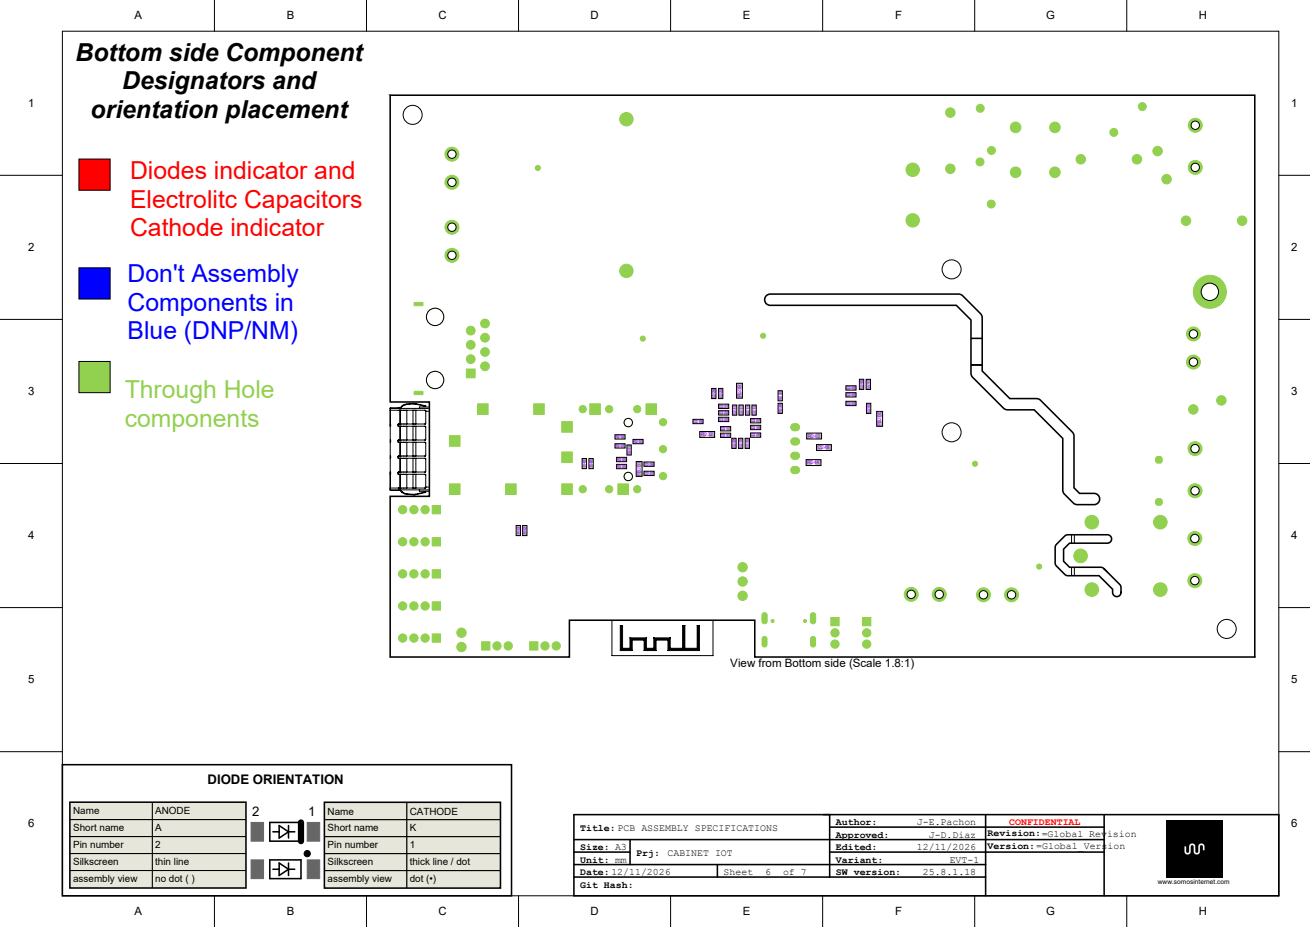
[picture p22: page 6]

View from Bottom side (Scale 1.8:1)

Title: PCB ASSEMBLY SPECIFICATIONS | Author: J-E.Pachon | CONFIDENTIAL

Approved: J-D.Diaz | Revision: =Global_Revision

Size: A3 | | Edited: 12/11/2026 | Version: =Global_Version

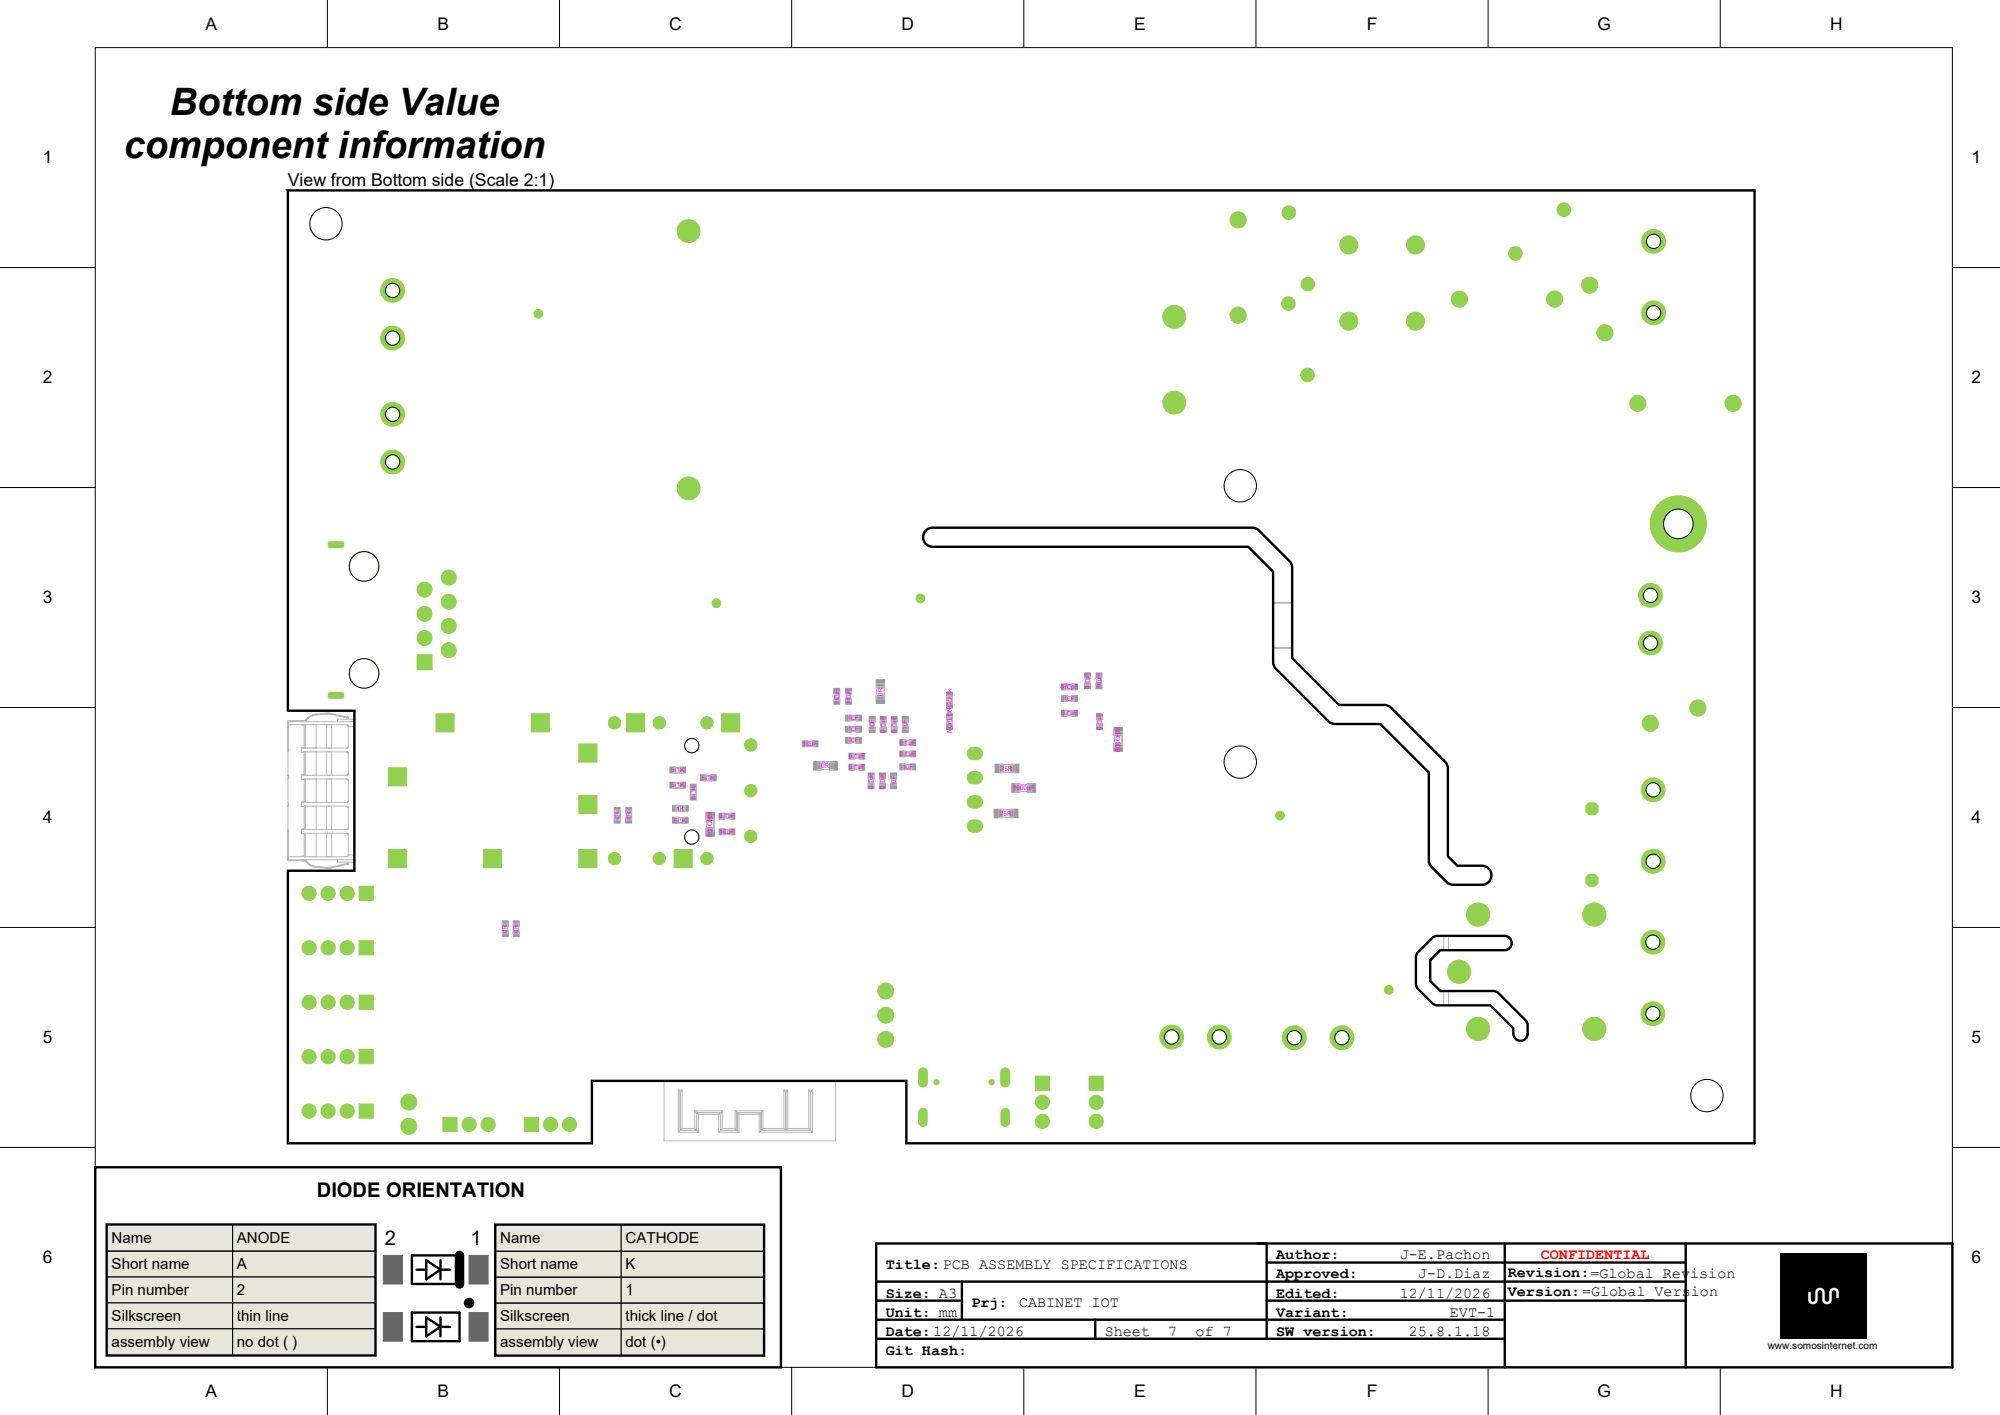
[picture p23: page 7]

View from Bottom side (Scale 2:1)

Title: PCB ASSEMBLY SPECIFICATIONS | Author: J-E.Pachon | CONFIDENTIAL

Approved: J-D.Diaz | Revision: =Global_Revision

Size: A3 | | Edited: 12/11/2026 | Version: =Global_Version
