SOMOS-HARDWARE-DESIGN/PRJ_CABINET_IOT/(list of files, drawings)

Other design files:
000_MCU - ESP32.SchDoc
100_Power Supply.SchDoc
200_Ethernet.SchDoc
300_Control.SchDoc
400_Sensors.SchDoc
500_External.SchDoc
CABINET_IOT-V1.PrjPcb
Main-CABINET_IOT-V1.PcbDoc
Main.SchDoc
