SOMOS-HARDWARE-DESIGN/PRJ_CABINET_IOT/(commit log)

2026-10-01 feat(prj): Cabinet_IOT project was created
    [000_MCU - ESP32.SchDoc, 100_Power Supply.SchDoc, 200_Ethernet.SchDoc, 300_Control.SchDoc, 400_Sensors.SchDoc, 500_External.SchDoc, CABINET_IOT-V1.PrjPcb, Main-CABINET_IOT-V1.PcbDoc]
2026-10-04 ESP32 SHEET SCHEMATICS ADDED
    [000_MCU - ESP32.SchDoc, CABINET_IOT-V1.PrjPcb]
2026-10-05 - POWER and Ethernet SHEET SCHEMATICS ADDED
    [100_Power Supply.SchDoc, 200_Ethernet.SchDoc, CABINET_IOT-V1.PrjPcb]
2026-10-05 MCU SHEET PINOUT UPDATE
    [000_MCU - ESP32.SchDoc, 400_Sensors.SchDoc]
2026-10-05 - Ethernet and power sheet modified
    [100_Power Supply.SchDoc, 200_Ethernet.SchDoc]
2026-10-06 feat(sch): control sheet was added
    [100_Power Supply.SchDoc, 200_Ethernet.SchDoc, 300_Control.SchDoc]
2026-10-16 Energy Meter schematics added
2026-10-16 Power and control sheets updated
2026-10-19 Sensors SCH updates
2026-10-19 RS232 converter, Uart Multiplexer, USB to UART convert added
2026-10-20 update(Schs): the Schs for the Sensors is under updating, the HLW8032 circuit was updated, updating process in progress..
2026-10-20 temp & humidity, CO, Water sensor, connectors were added. liimt switch was added
2026-10-20 1GPIO control FAN, 2 NM connectors for temperature sense, RX LOSS and MOD_ABS connected.
2026-10-21 update(schs): the Sensors sheet was captured, the full schs were annoted. Capture schs in progress....
2026-10-21 update(Schs): the note for the ADDR I2C for the acelerometer was added
2026-10-21 update(Schs): the Accelerometer sensor was moved to the external sheet, the VAC transformer sensor was removed. updating shcs in progress...
2026-10-21 update(Schs): the note for the implementation of the multiple meeasurments circuit, updating in progress...
2026-10-22 I2C Mux added, Main sheet done, warning and errors fixed. SCH compiled.
2026-10-23 I2C MUX for temperature sensor was added
2026-10-23 sensors name and address were added
2026-10-26 schematics organized, some placement block done
2026-10-26 update(schs): some resistors for the I2C mux was connected to 3V3 in MCU sheet. The CT2 circuit was added in the sensor schs
2026-10-26 update(PCB): Group component blocks for first placement attempt. Placement in progress...
2026-10-27 update(PCB): component placement was updated. Placement in progress...
2026-10-30 update(PCB): Create power polygons, route AC lines, and optimize trace routing
2026-11-05 Relay modified, earth connection to chasis added, inductor choke fixed, Mosfet gate resistor changes to 100R
2026-11-07 Schematics Review & Components Placement Revision
2026-11-11 PCB Updates Revision V1
2026-11-11 cut out in SFP connector added, LDO 3V3 changed 1.5, Desginators fixed
